wdzz8/ads8688-mos-test-platform/固定栅压输出特性下一步_20261102.md

# 固定栅压输出特性：下一步操作

> 最新状态：DAC2432/2560/2688/2816四条曲线已完成，见[多栅压输出特性实测_20261102.md](output/pcb1/fixed_vgs_20261102/family_20261102_173244/多栅压输出特性实测_20261102.md)。FPGA已恢复DAC256低栅压，ADC复核通过，DPS输出关闭。下文保留第一条曲线的操作过程；当前下一步见[标定与动态下一步_20261102.md](标定与动态下一步_20261102.md)。

当前自动栅压扫描已经完成。要测标准的 MOS 输出特性，需要固定 VGS，只改变 VDS。已有程序继续扫描栅压，不能直接把那组数据当成输出特性。

## 已准备好的镜像

先用这个镜像做第一条固定栅压曲线：

```text
output/mos_fixed_vgs/code_2560/mos_fixed_vgs.bit
output/mos_fixed_vgs/code_2560/mos_fixed_vgs.ltx
```

DAC 码 2560 在前一轮实测对应 VG 约 2.04 V，位于已观察到的导通过渡区。

## 你需要做的唯一硬件动作

1. DPS 输出保持关闭；OPA 正、负电源和 GND 都保持稳定。
2. 当前自动扫描接线保持不变，DG4102 保持断开。
3. 在 Vivado Hardware Manager 手动 Program 上述 `.bit`，同时加载同目录 `.ltx`。
4. 看到 LED3 正常亮、JTAG 仍可识别后，回复“固定2560已下载”。

下载期间不要给 DPS 开输出。这个镜像只把栅压固定在约 2.04 V，ADC 会连续输出稳定快照；随后运行自动 VDS 阶梯采集，每一级结束都关闭 DPS。

## 零点和自动采集

先在 DPS 输出关闭状态下，用同一 `code_2560` 镜像执行一次固定栅压采集，保存为零电流基线。当前已保存的验证基线为：

```text
output/pcb1/fixed_vgs_20261102/zero_code2560.csv
```

该文件包含 256 行有效数据，实测 VG 均值约 2.04446 V，行内范围约 1.25 mV；DPS 回读为输出关闭。

可用自动采集器逐点完成 DPS 阶梯和 ILA 导出：

```powershell
python scripts/capture_fixed_vgs_output.py --port COM3 --dac-code 2560 `
  --zero-csv output/pcb1/fixed_vgs_20261102/zero_code2560.csv
```

每个点默认保存 128 行；任何 DPS 状态异常、ILA 超时、固定 DAC 码不符或采集行数不足都会停止后续点，并尝试验证关闭输出。采集报告保存于 `output/pcb1/fixed_vgs_20261102/run_<timestamp>/`。

## 之后的测量顺序

保持同一接线，DPS 依次设定 0.2、0.5、1.0、1.5、2.0、2.5、3.0 V，限流保持 20 mA；每个点采集 VD、VS、INA OUT，并用 DPS OFF 零点扣除 INA。采集结束后运行：

```powershell
python scripts/analyze_fixed_vgs.py `
  output/pcb1/fixed_vgs_20261102/run_<timestamp>/fixed_vgs_output_report.json
```

本轮 DAC 码2560的实测结果已保存为[固定栅压输出特性实测结果_20261102.md](output/pcb1/fixed_vgs_20261102/固定栅压输出特性实测结果_20261102.md)。随后再构建 2304、2816、3072 等 DAC 码，重复同一组 VDS，得到多条固定 VGS 输出曲线。

## 验收标准

- 每个固定栅压镜像的实测 VG 在全部采样行内变化小于约 20 mV。
- row_valid、ADC 初始化和 DAC 状态正常，不能出现全 FFFF。
- 每个 VDS 点结束后 DPS 回读 `output_enabled=false`、实际输出 0 V。
- 输出数据保留原始 VD/VS/INA；电流标定仍需使用已测 R1 或外部标准电流，暂不宣称数据手册参数已精密测出。
