wdzz8/ads8688-mos-test-platform/初赛创新点与视频策略_20261103.md

# FPGA 创新设计赛道初赛创新点与视频策略

## 1. 通知中真正影响初审的指标

2026 年竞赛通知（第一轮）明确提到，资格审核和作品评审会关注：

- 材料完整度；
- 项目创新性和科学性；
- 工程可行性；
- 设计难度；
- FPGA 平台适用度。

初赛采用作品报告、视频等材料的线上评审。决赛包含作品介绍与演示、专家提问，以及 FPGA 基础编程设计能力考核。因此，初赛材料需要让评委在几分钟内看清楚“为什么必须用 FPGA、系统是否真的运行过、遇到异常是否能处理、结果是否可复现”。

## 2. 建议采用的项目定位

建议项目名称统一为：

> **面向功率 MOS 的 FPGA 闭环参数测试与边缘诊断平台**

建议摘要中的主线是：

> 平台由 AX7020 FPGA 协调 DAC 栅压、可控漏极电源和 ADS8688 八通道采集链路，在 FPGA 端保留时间戳、序号、通道切换标记和坏行标志，在上位机端完成恒 VDS 闭环、质量门控和可解释参数提取，实现从激励、采样、异常恢复到曲线分析的完整证据链。

这比“自动画 MOS 曲线”更能对应竞赛所要求的 FPGA 应用创新、工程实践和复杂问题解决能力。

## 3. 最值得突出且可以真实支撑的三项创新

### 创新一：面向目标 VDS 的闭环测试编排

测试流程不是固定延时后画图，而是：

1. FPGA 输出可编程栅压并连续采集多通道数据；
2. 上位机根据源压扣零后的 VDS 回读误差调整 DPS；
3. 只有在 VDS 落入目标窗口后才接受该点；
4. 每个点保存设定值、回读值、迭代次数和最终接受依据。

当前真实证据是 9 个恒 VDS 转移点，VDS 保持在约 0.500 V ± 15 mV，并且报告保留了每点迭代和电源关闭回读。视频中应把“目标值—第一次误差—调整—接受”做成 10 秒的局部放大镜头。

后续可扩展为“粗扫—发现拐点—局部加密”的自适应采样。初赛可以把它作为已有闭环流程的增强设计，明确标注实机已验证的部分和后续计划，避免把未跑过的策略说成实测结果。

### 创新二：FPGA 端数据质量门控与异常自诊断

ADS8688 的偶发 FFFF 不能被隐藏，反而可以成为工程能力证据。当前链路已经保留：

- 采样序号和时间戳；
- 通道切换标记；
- FFFF/坏行计数；
- 配置变化检测；
- ILA 原始证据；
- 独立 ADC 复位和重新初始化路径。

建议把它命名为“采样质量门控”：坏行直接拒收，触发重初始化，恢复后再继续采集；报告同时保存有效行数、拒收行数、恢复动作和最终 DPS OFF 回读。这样评委看到的是一个能处理现场异常的 FPGA 工程系统，而不是只在正常情况下出一张漂亮曲线。

视频应展示一张真实诊断日志：异常帧被标红、状态机进入恢复态、重新初始化后有效行恢复。不要宣称已经隔离 FFFF 的唯一硬件根因，只说“系统能检测并恢复，根因仍在定位”。

### 创新三：重复性、置信区间和留一验证

每个静态点保留 128 行原始采样，不只输出一条连线。分析层可以同时给出：

- 重复采样标准差或标准误；
- 有效行比例；
- VDS 是否落在接受窗口；
- 经验模型的留一点评估误差；
- 转移曲线的有限差分 gm；
- 动态频率、周期离散度和占空比。

这使“科学性”有可见证据，也能在答辩时回答“曲线是否只是偶然噪声”。当前真实数据已经支持 3,584 个固定栅压输出行、24,576 组动态数据和 9 个恒 VDS 转移点，演示页面也已经展示模型和动态指标。

## 4. 可以作为加分项的扩展

### 4.1 可解释轻量模型和残差地图

当前每条输出曲线使用紧凑经验模型，并保存留一预测。建议在报告中增加“残差随 VDS/VGS 的热力图”，让系统自动指出模型失配最大的区域，并建议下一轮在该区域加密采样。这比直接套用黑盒神经网络更容易解释，也更适合 FPGA 竞赛答辩。

当前已经补充一个独立的研究性智能层：使用真实 28 个静态采样点训练固定种子的 2-8-1 TinyMLP，并进行留一验证；同时根据留一残差和局部斜率变化给出每条曲线的两个候选 VDS 加密点。该模型只用于探索性回归和测试规划，硬件验收仍由 FPGA 标志、DPS 回读和规则窗口完成。演示入口为“智能规划”页，数据文件为 `demo/data/intelligent_analysis.json`，可复现命令为 `python scripts/intelligent_analysis.py`。

### 4.2 器件画像和自动分档

把一次测试的结果保存为器件画像：VGS@1 mA、最大 gm、低压导通电流、饱和区拟合参数、重复性和异常率。将来插入两只 2N7000 或不同型号 MOS 时，可以自动输出“参数相近/异常/需复测”标签。初赛可先展示单器件画像，决赛再扩展多器件对比。

### 4.3 面向安全工作区的测试约束

把 VDS、限流、栅压变化率、单点超时和 DPS OFF 回读写成统一的测试约束，并在界面显示“允许/拒绝原因”。当前软件已经限制 0–5 V、0–50 mA 的控制范围，实验数据使用不超过 3 V、20 mA 的包络；独立硬件关断尚未完成验证，因此材料中应称为“软件测试约束和关断回读”，不要称为独立硬件保护。

### 4.4 可插拔器件配置

将通道映射、分流电阻、放大倍数、DAC 范围和安全上限放入器件配置文件，使平台从“2N7000 专用”变为“可换器件测试框架”。这是工程化加分项，适合写进设计难度和后续展望，当前不需要为了它重构全部 RTL。

### 4.5 FPGA 实现证据页

竞赛明确考察 FPGA 平台适用度。当前已从交付 bit/LTX、综合日志和 timing report 生成工程指标页，展示 50 MHz 目标时钟、8 通道 416 µs 行周期、ILA 证据、Setup WNS、Hold WHS、失败端点数以及综合 LUT/寄存器/CARRY4 数量。它能把“用了 FPGA”具体化为可审查的确定性数据路径和实现结果。

## 5. 截止提交前的优先级

### 必做

1. 报告和视频统一使用“闭环测试 + 质量门控 + 可解释分析”三条主线；
2. 展示真实 PCB、AX7020 下载、DPS 回读和原始采样证据；
3. 在画面上明确区分实测值、名义换算值和趋势代理；
4. 附上源代码、bit/LTX、复现命令和离线演示入口；
5. 准备一个异常恢复镜头和一个恒 VDS 收敛镜头。

### 有时间再做

1. 在离线演示增加“质量门控/异常恢复”标签页；
2. 在分析 JSON 增加每个点的有效率、标准差和残差；
3. 增加“下一采样点建议”的自适应规划器，并标记为规划器演示或离线回放；
4. 添加器件画像导出 JSON/CSV。

### 不建议在提交前临时加入

- 没有实机证据的神经网络或“AI 自动识别”宣传；
- 未验证的精密绝对电流精度、MOS 本征开关速度和独立硬件保护；
- 只增加按钮、动画或 3D 外观而不增加 FPGA 数据路径和可复现实验；
- 伪造数据、伪造实物效果或把离线回放说成现场实测。

## 6. 三分钟视频建议结构

1. **0:00–0:20 问题**：人工示波器/万用表无法同时完成可编程激励、八通道同步证据和异常筛选。
2. **0:20–0:50 架构**：AX7020、MCP4725、ADS8688、DPS、INA240、MOS 测试板的信号流。
3. **0:50–1:25 实物运行**：下载 FPGA、设置栅压、DPS 输出、实际 MOS 和界面同步变化。
4. **1:25–1:55 闭环证据**：恒 VDS 目标、调整过程、9 点结果和 0.500 V ± 15 mV。
5. **1:55–2:20 异常恢复**：FFFF/坏行标记、拒收、重新初始化、恢复后的有效数据。
6. **2:20–2:45 算法结果**：输出特性、转移曲线、gm、频率/占空比、重复性和留一误差。
7. **2:45–3:00 竞赛价值**：FPGA 数据路径、工程约束、开放源代码、后续可插拔器件和自适应采样。

## 7. 边界表述

当前项目可以有竞争力，但材料应把“实测已完成”和“规划增强”分开写。精密电压/电流标定、FFFF 的唯一根因、独立硬件关断目前仍是限制项；它们不妨碍展示系统的闭环流程和工程化能力，却不能被写成已经完成的验收结论。
