wdzz8/ads8688-mos-test-platform/交付状态_20261102.md

# 交付状态（2026-11-02）

## 已完成

- 统一实验固件 `output/mos_experiment/mos_experiment.bit/.ltx` 已构建并在 AX7020 上实测。
- 固定 VGS 输出特性：4 个栅压、7 个漏极点、每点 128 行，共 3,584 个有效行。
- 动态方波：1、5、10 Hz 各 8,192 组，共 24,576 组；实测频率约 0.99994、5.00020、10.00088 Hz，占空比约 0.5；每轮 DPS 输出均 OFF 回读。
- 恒 VDS 转移特性：9 个栅压点，VDS 均在 0.5 V ± 15 mV；已提取有限差分 gm 和阈值趋势代理。
- 分析脚本会重新读取原始 CSV，拒绝 FFFF、坏行、错误 DAC 码和未经验证的电源状态。
- 离线交互演示 `demo/index.html`、紧凑数据 `demo/demo_data.js`、数据回放 `demo/mos_data_replay.mp4` 已生成。

## 关键复现命令

```powershell
python scripts/analyze_experiments.py
python scripts/build_demo_bundle.py
python scripts/render_demo_video.py
python -m unittest discover -s tests -p "test_*.py" -v
```

双击 `demo/index.html` 可以离线查看页面。实物拍摄请按 `视频拍摄分镜_20261102.md` 执行。

## 结论边界

当前 ID 使用 INA240 20 V/V、0.1 Ω 分流器的名义系数，并用匹配 DPS OFF 基线扣除零点；精密绝对电压/电流标定仍未完成。经验模型用于比较和留一验证，不等同于 MOS 本征模型。动态频率指标是整机采样系统响应，不代表 MOS 本征开关速度。此前 ADC FFFF 可通过重新初始化恢复，但根因仍保留在历史诊断文档中。

## GitHub

公开仓库：[wdzz8/ads8688-mos-test-platform](https://github.com/wdzz8/ads8688-mos-test-platform)。本地交付基线 `485d741` 已推送，当前 README 链接更新正在同步。
