wdzz8/ads8688-mos-test-platform/完整硬件接线与测试说明_20261101.md

# AX7020 + ADS8688 + MCP4725 + OPA192 + INA240 + 2N7000

当前接线已切换为 2026-11-02 新 Q1 的截止复测，以 [当前PCB完整接线_截止复测_20261102.md](当前PCB完整接线_截止复测_20261102.md) 为准。本文件保留历史完整/导通接法；当前 J9 接地、OPA 输出断开、J16-5 漏极采样线暂时断开，不能混用两种状态。

## 1. 项目目标

系统用于测量 2N7000 的静态特性。AX7020 负责数字控制和数据采集，MCP4725/OPA192 产生栅极电压，DPS 产生漏极电压，INA240 把源极电流变成可采集的电压，ADS8688 采集栅极、漏极、源极和电流信号。

当前阶段先做低压、短时、可人工确认的测试；DPS 输出暂时由面板/电脑手动控制，不能把 DPS 误认为已经由 FPGA 自动控制。

## 2. 已确认的硬件

- AX7020：FPGA 为 XC7Z020，AX7020 实物上的扩展接口是 **J11**。
- PCB 上对应的扩展接口是 **J21**；如果使用排线连接，按相同针号把 AX7020 J11 接到 PCB J21。后文凡写 J11 都指 AX7020，凡写 J21 都指 PCB。
- Q1：工程中为 onsemi 2N7000，TO-92-3L。
- 对本次实物“2N7000 JCAZW”，平面朝向自己、引脚向下时，已由体二极管测试确认：1=S，2=G，3=D。
- PCB 已焊好 Q1、R1、R2、R3 等元件；外部模块和旧台架线尚未迁移。
- DPS 电脑通信已经恢复，COM3 可识别；最新已确认的测试状态是输入约 11.97 V、设定 1.00 V/20 mA、输出关闭。

## 3. 整个功率和测量回路

```text
DPS OUT+ ──> J10-1 (VD_SUPPLY) ── PCB R1=1 kΩ ──> Q1-3 D
DPS OUT- ──> J10-2 (GND)

Q1-1 S ──> VS ──> INA240 IN+
                  INA240 模块内部分流电阻
              INA240 IN− ──> 公共 GND ──> J10-2/DPS OUT−

栅极源 ──> J9 中心 ── SW1(AUTO) ── PCB R2=1 kΩ ──> Q1-2 G
Q1-2 G ── PCB R3=100 kΩ ──> GND
```

因此，PCB 上已经有：

- R1=1 kΩ：`VD_SUPPLY` 到 Q1 漏极 `VD`；
- R2=1 kΩ：`VCTRL` 到 Q1 栅极 `VG`；
- R3=100 kΩ：`VG` 下拉到 GND。

迁移到 PCB 后，旧台架的 100.50 Ω 漏极电阻、910 Ω 栅极电阻、外部 100 kΩ 下拉都应拆掉，不要与板上 R1/R2/R3 叠加。DPS 正端接 J10-1，不能直接接 Q1-3。

## 4. INA240 只有一个

整套系统只使用一个外置 INA240 模块。J2 和 J14 是同一组 VS/GND 网络的两种引出方式，J14 不是第二个 INA240。

推荐使用 J2 的完整六针接口：

| PCB | INA240 模块 |
|---|---|
| J2-1 | VCC，接 +5V_ANA |
| J2-2 或 J2-3 | GND |
| J2-4 | OUT，送 ADS8688 模拟输入 |
| J2-5 | IN− |
| J2-6 | IN+ |

使用这个方案时 J14 完全不接线。

如果线束必须分开，也可使用方案 B：J2-1 接 VCC，J2-2/3 接 GND，J2-4 接 OUT，J14-1 接 IN+，J14-2 接 IN−；此时 J2-5、J2-6 不接。方案 A 和方案 B 只能选一个，不能接两个 INA240，也不能用导线把 VS 直接短到 GND，否则会旁路 INA240 的分流电阻，电流读数会失效。

## 5. 栅极部分

### 自动栅压链路

```text
MCP4725 VOUT ──> J8 中心 ──> OPA192 输入
OPA192 输出 ──> J9 中心 ──> SW1 的 AUTO 端
SW1 AUTO ──> VCTRL ── PCB R2=1 kΩ ──> Q1 G
```

OPA192 使用 +5 V、GND、−5 V 三电源，电源接 J7/J13 对应端子。J8/J9 的外壳均为 GND。

### 第一次固定电压检查

先不要让 OPA 输出和 MCP4725 输出同时接到栅极。DPS 关闭时，可以把已确认的 3.3 V 安全地送到 J9 中心，SW1 拨到 AUTO，使用板上 R2/R3。由于 R3=100 kΩ 下拉，理论栅压约为 `3.3×100k/(100k+1k)=3.27 V`，应使用万用表测 Q1-2 对 Q1-1 的 VGS。

如果万用表读到约 0.005 mV，说明栅极没有得到 3.3 V，通常是供电点、SW1 位置或 J9 中心接线错误；这不表示 MOS 已损坏。

## 6. AX7020、ADS8688、MCP4725 的线

### AX7020 J11 到 PCB J21

| AX7020 | PCB | 信号 |
|---|---|---|
| J11-1 | J21-1 | GND |
| J11-2 | J21-2 | +5V_FPGA |
| J11-3 | J21-3 | ADC_CS_N |
| J11-4 | J21-4 | ADC_SCLK |
| J11-5 | J21-5 | ADC_SDI |
| J11-6 | J21-6 | ADC_SDO |
| J11-7 | J21-7 | ADC_RST_N |
| J11-9 | J21-9 | MCP_SCL |
| J11-10 | J21-10 | MCP_SDA |
| J11-37/38 | J21-37/38 | GND |
| J11-39/40 | J21-39/40 | +3.3V |

J11-2/J21-2 是 FPGA 侧 5 V 电源标识，不要把它误认为 ADS8688 的模拟 5 V。ADS8688 和 INA240 的模拟 5 V 仍按下面的 J15/J2 供电；J11-9/J11-10 也不是电源，而是 I2C。

如果使用杜邦线而不是 40 针排线，至少接以下信号：

| AX7020 J11 | PCB J21 | 信号 |
|---|---|---|
| J11-3 | J21-3 | ADC_CS_N |
| J11-4 | J21-4 | ADC_SCLK |
| J11-5 | J21-5 | ADC_SDI |
| J11-6 | J21-6 | ADC_SDO |
| J11-7 | J21-7 | ADC_RST_N |
| J11-9 | J21-9 | MCP_SCL |
| J11-10 | J21-10 | MCP_SDA |
| J11-37/38 | J21-37/38 | GND |
| J11-39/40 | J21-39/40 | +3.3V |

### ADS8688 模块

- ADS8688 模拟电源接 +5 V，GND 接公共地，DAISY 接 GND。
- ADS 模块数字线接 PCB J15：J15-1/2/3/4/5 分别为 SDI/RST/SCLK/CS/SDO；J15-6～9 接 GND；J15-10 接 +5V_ANA。
- PCB J16 是模拟采样口：J16-3=ADC_ID，J16-4=ADC_VG，J16-5=ADC_VD，J16-6=ADC_VS；J16-1 和 J16-10 接 GND。

模块丝印从 AIN1 开始，而芯片通道从 CH0 开始，所以物理对应是：

- J16-3 → 模块 AIN8 → 芯片 CH7：INA240 OUT；
- J16-4 → 模块 AIN1 → 芯片 CH0：VG；
- J16-5 → 模块 AIN2 → 芯片 CH1：VD；
- J16-6 → 模块 AIN3 → 芯片 CH2：VS。

### MCP4725 模块

- J6-1/J6-5：GND；
- J6-2：+3.3 V；
- J6-3：SDA；
- J6-4：SCL；
- J6-6：MCP4725 VOUT/DAC_GATE_RAW。

SDA、SCL 各保留一个约 2.2 kΩ～4.7 kΩ 的上拉到 3.3 V；模块 A0 按当前工程使用 0x60 地址的接法保持不变。

## 7. 断电检查顺序

所有电源关闭、DPS OUT 关闭、万用表电阻档：

1. J10-1 到 Q1-3 应约为 1 kΩ；J10-1 到 GND 不应短路。
2. Q1-2 到 GND 应约为 100 kΩ。
3. SW1 拨 AUTO 时，J9 中心到 Q1-2 应约为 1 kΩ；拨 MANUAL 时，检查 RV1 到 VG_MANUAL 的变化。
4. Q1-1、J14-1、J2-6 应为同一网络；J14-2、J2-5、GND 应为同一网络。
5. J10-2、J14-2、INA240 GND、ADS GND、MCP GND、AX7020 GND 必须互通。
6. 不应存在 J10-1 到 GND、J9 中心到 GND 的异常低阻短路。

## 8. 上电和测量顺序

1. 断开 DPS 输出，只上 AX7020、ADS8688、MCP4725、INA240 和 OPA192 的低压电源；先量 +3.3 V、+5 V、−5 V。
2. 下载同一次生成的 `mos_scan.bit` 和 `mos_scan.ltx`，检查 ADS8688 初始化、MCP4725 ACK、ILA 数据是否正常。
3. 栅极先保持 SW1=MANUAL、RV1 最低，或让 J9 输入一个已知的 0 V；确认 VGS≈0 V。
4. 送 3.3 V 到 J9 中心、SW1=.AUTO，在 DPS 仍关闭时测 VGS；预期约 3.27 V。
5. DPS 设 1.00 V、限流 20 mA，正端接 J10-1、负端接 J10-2，先测 VDS（红笔 Q1-3，黑笔 Q1-1）。
6. VGS≈0 V 时，VDS 应接近 1 V；VGS≈3.27 V 时，VDS 应明显下降并出现源极电流。每次只开启很短时间，观察 DPS 是否进入 CC。
7. 同时记录：DPS 输出电压、Q1 VDS、Q1 VGS、VS 对 GND、INA OUT 对 GND 和 ADS8688 对应通道。
8. 通过 1 V 低压确认后，再逐步提高漏极电压或扫描栅压；不要直接跳到高电压。

## 9. 已完成的实验说明

- 体二极管方向一次约 0.5896 V、反向 OL，支持 1=S、2=G、3=D 的判断。
- G/S 短接、DPS 1.00 V/20 mA 时测到 VDS=1.003 V，DPS 回报 0.000 A。这是截止检查，不是完整漏电流精度证明。
- 100.50 Ω 旧台架负载下，1 V 测得 0.9790 V；3 V/20 mA 条件下测得约 2.23 V，说明曾经接近限流边界。
- 之前固定栅压测试的 VGS=0.005 mV，是 3.3 V 取电链路没有建立的结果，不能作为 MOS 导通能力结论。

## 10. 精度边界

真正的低电流精度主要受 INA240 模块零点、内部分流电阻阻值、INA 增益误差、ADS8688 量程/基准、DPS 显示分辨率以及 MOS 温度影响。不能只看 FPGA 的 ADC 码值就宣称精度。

正式扫描前应先记录：DPS 关闭、VGS=0 时的 INA OUT 零点；再用已知电流点做增益校准。若模块是常见增益 20、分流电阻 0.1 Ω 版本，电流换算近似为：

```text
I = (INA_OUT - INA_ZERO) / (20 × 0.1 Ω)
```

实际使用时还要用实测增益和实测分流电阻替换名义值。低于几毫安的点先标为“待校准”，不要把它们当成高精度数据。

## 11. 当前没有完成的部分

- PCB 迁移后的断电通断检查尚未实测记录。
- 外部模块到 J2/J6/J15/J16/J21/J10 的线尚未全部接好。
- DPS 的 FPGA 自动控制接口仍是预留项；目前 DPS 由 COM3/面板控制。
- `mos_scan` 的自动曲线只有在栅极、漏极和 INA/ADC 通道实测确认后，才可以作为有效 MOS 曲线。
