wdzz8/ads8688-mos-test-platform/当前PCB完整接线_截止复测_20261102.md

# 当前 PCB 完整接线：新 Q1 截止复测（2026-11-02）

> 此文件是历史截止复测状态，OPA 断开/J9 接地的要求不适用于当前自动扫描。当前接线见 [当前PCB自动扫描接线_20261102.md](当前PCB自动扫描接线_20261102.md)。

本文件给出本轮目标接线，不表示所有接线已由仪器确认。AX7020 上用 J11，PCB 上用 J21。当前任务是复测新焊接 Q1 在 VGS≈0 V、DPS 输出 1.00 V 时的截止行为。全部改线必须断电，DPS OUT 关闭。

## 本轮三个关键状态

- PCB J9 中心接 PCB GND，SW1 选择 AUTO；原 3.3 V 栅压测试线拆掉。
- OPA192 输出与 PCB J9 断开，DG4102 输出线断开；OPA 输入和供电可保留。
- PCB J16-5 到 ADS8688 模块 AIN2 的漏极采样线暂时断开；PCB J4 不接仪器。

## 1. AX7020 与 PCB

若已使用 40 芯排线，保持 AX7020 J11 与 PCB J21 同针号连接，按连接器 Pin 1 标识核对方向；不要按照片左右方向猜针号。若用杜邦线，本轮使用的连接如下：

```text
AX7020 J11-3  -> PCB J21-3   ADC CS
AX7020 J11-4  -> PCB J21-4   ADC SCLK
AX7020 J11-5  -> PCB J21-5   ADC SDI
AX7020 J11-6  -> PCB J21-6   ADC SDO
AX7020 J11-7  -> PCB J21-7   ADC RST
AX7020 J11-9  -> PCB J21-9   MCP SCL
AX7020 J11-10 -> PCB J21-10  MCP SDA
AX7020 J11-37 -> PCB J21-37  GND
AX7020 J11-38 -> PCB J21-38  GND
AX7020 J11-39 -> PCB J21-39  +3.3 V
AX7020 J11-40 -> PCB J21-40  +3.3 V
```

J11-1/J21-1 也为 GND。J11-2/J21-2 为 +5V_FPGA，和 +5V_ANA 是不同网络；本轮不用另外从这一脚给模拟模块供电。PCB J20 不用。AX7020 沿用自身已验证的电源与 USB JTAG。

J21 到 J15/J6 的连接已在 PCB 内，不再另加跨接线。SPI/I2C 原来直接连接 AX7020 和模块的重复线束应移除，统一经过 PCB。

## 2. IT 模拟电源与 PCB

第一台 IT6302 沿用已经验证的 +5 V、0 V、−5 V 三个节点，不重新猜测通道端子极性：

```text
已验证的 +5 V -> PCB J13-1 (+5V_ANA)
系统 0 V     -> PCB J13-2 (GND)
已验证的 -5 V -> PCB J13-3 (-5V_OPA)
```

本轮只从 J13 输入模拟电源。PCB P1 留空，因为 P1-1 与 J13-1 同网、P1-2 与 J13-2 同网。原来 CH3 独立 +5 V 到 ADS/INA 的供电线应断电移除，避免把独立电源输出直接并接到 +5V_ANA。ADS/INA 改由 PCB J15/J2 取电。

AX7020 的 3.3 V 给 MCP4725；不要新增另一台 3.3 V 电源并联到这条电源轨。

## 3. INA240：只使用一个模块

统一使用 J2 完整接口，J14 留空：

```text
PCB J2-1 -> INA240 VCC (+5 V)
PCB J2-2 -> INA240 GND（J2-3 是相同 GND，可代替 J2-2）
PCB J2-4 -> INA240 OUT
PCB J2-5 -> INA240 IN-
PCB J2-6 -> INA240 IN+
```

Q1 源极 VS 经模块已有 R100 分流电阻回地。不要额外把 Q1 源极直接短到 GND，也不要新增分流电阻。INA OUT 已通过板上采样网络送 J16-3，不再额外直连 ADC。

## 4. ADS8688

数字及供电：

```text
PCB J15-1  -> ADS SDI
PCB J15-2  -> ADS RST
PCB J15-3  -> ADS SCLK/CLK
PCB J15-4  -> ADS CS
PCB J15-5  -> ADS SDO
PCB J15-6  -> ADS GND（J15-7/8/9 也为 GND，不要求四脚全部各拉一根）
PCB J15-10 -> ADS VCC/AVDD (+5 V)
ADS DAISY  -> ADS 模块 GND
```

本轮模拟输入：

```text
PCB J16-3  -> 模块 AIN8 / P2-3（芯片 CH7），电流采样
PCB J16-4  -> 模块 AIN1 / P2-4（芯片 CH0），栅压 VG
PCB J16-5  -> 暂不接，ADS 模块 AIN2 / P2-5 的这根线拔掉
PCB J16-6  -> 模块 AIN3 / P2-6（芯片 CH2），源压 VS
PCB J16-1  -> ADS 模块模拟 GND（J16-10 也是 GND）
```

J16-2/7/8/9 本轮不接；PCB J4 和其余模拟测试端子不接示波器/其他外部负载。模块 AIN1～AIN8 与芯片 CH0～CH7 的编号有一位差异。漏极采样线恢复前，ADC CH1 的数据不能用作有效 VDS。

## 5. MCP4725

```text
PCB J6-1 -> MCP GND（J6-5 同为 GND）
PCB J6-2 -> MCP VCC/VDD (+3.3 V)
PCB J6-3 -> MCP SDA
PCB J6-4 -> MCP SCL
PCB J6-6 -> MCP VOUT/OUT
```

SDA/SCL 保留已验证的 3.3 V 上拉和 A0 地址 0x60 接法，不重复增加上拉。J6-6 与 J8 中心同网。MCP 输出可保留接 OPA 输入，但本轮 OPA 输出必须与 J9 断开，所以 FPGA 即使输出扫描波形也不应驱动栅极。

## 6. OPA192、DG4102 和 J9

PCB J7 针序已从最终工程确认：

```text
PCB J7-1 -> OPA192 VDD / +VS / 正电源 (+5 V)
PCB J7-2 -> OPA192 GND
PCB J7-3 -> OPA192 VEE / -VS / 负电源 (-5 V)
PCB J8 中心/外壳 -> OPA192 SMA-IN 中心/外壳
```

OPA192 模块电源端仍按其实际丝印匹配信号，不能假定模块插座左右方向与 PCB 相同。模块原有直供电线不要与 J7 重复接入另一台电源。

**本轮 OPA192 SMA-OUT 到 J9 的线拔掉。DG4102 输出线与 PCB/OPA 输入断开。**

```text
PCB J9 中心 -> PCB J9 外壳 / 公共 GND
SW1         -> AUTO（工程网络为 SW1-1 VG_AUTO，SW1-2 VCTRL）
```

因此，Q1 栅极经板载 R2 接地，R3 也保留在板上，不需要直接短接 Q1 引脚。

## 7. Q1 和板载电阻

```text
Q1 焊盘 1 = VS = 源极 S
Q1 焊盘 2 = VG = 栅极 G
Q1 焊盘 3 = VD = 漏极 D
```

对本次同批裸管，平面朝用户、引脚向下时，左/中/右已由体二极管测试支持 S/G/D；安装时须与 PCB 焊盘编号匹配，不凭器件旋转后的“左脚”猜网络。

- R1 设计 1 kΩ，用户实测约 0.99 kΩ：VD_SUPPLY 到 VD。
- R2 设计 1 kΩ：VCTRL 到 VG。
- R3 设计 100 kΩ：VG 到 GND。
- 不再接旧台架的 100.50 Ω、910 Ω或外部 100 kΩ；裸管测试用 100 kΩ不移到 PCB。

## 8. DPS3005 和第二台 IT6302

第二台 IT6302 的原独立 12 V 通道：

```text
同一通道 +12 V 正端 -> DPS IN+
同一通道负端       -> DPS IN-
DPS OUT+           -> PCB J10-1 (VD_SUPPLY)
DPS OUT-           -> PCB J10-2 (GND)
```

输入侧保持原已验证接法，不新增到系统地的跨接；不假定 DPS 输入/输出隔离。DPS 使用配套 USB 通信板接电脑：COM3、9600、8N1、地址 1；不接 AX7020 UART。

设定 1.00 V、0.020 A，输出先关闭。软件“打开/关闭”是输出开关，“断开”是通信开关。DPS 正端不能直接接 Q1 漏极绕过 R1。

功率回路为：DPS OUT+ → J10-1 → R1 → Q1 D → Q1 S → INA 模块分流电阻 → GND → J10-2 → DPS OUT−。

## 9. 公共地和本轮上电

公共地是 PCB GND、AX7020 J11 GND、ADS GND、MCP GND、INA GND/IN−、OPA GND、DPS OUT−、第一台 IT 的系统 0 V。−5 V 电源轨不等于 GND。

1. 全部断电完成上面的线束和新 Q1 焊点检查。
2. 开启 AX7020 与第一台 IT 的模拟电源，确认 +3.3 V、+5 V、−5 V 对系统 GND 的极性。
3. 开启给 DPS 输入供电的约 12 V 通道，确认 DPS OUT 关闭，设定 1.00 V/0.020 A。
4. 万用表直流电压档，红 Q1-2、黑 Q1-1，确认 VGS 接近 0 V。
5. 红 Q1-3、黑 Q1-1，开启 DPS 数秒，记录 VDS 和实际输出电压，随后关闭输出。此次截止 VDS 预期接近 1 V，异常时不升压。
6. 本轮不要求重新下载波形固件，不需要 DG4102 或示波器。只有确认截止恢复后，才恢复 J16-5 采样线做对照；OPA 输出恢复前要先解除 J9 对地连接。

## 10. 状态记录

用户报告 Q1 已更换重焊；新 Q1 在漏极采样断开时测得截止 VDS=1.003 V，接回 J16-5 后用户确认仍正常。固定栅压复测 VGS=3.248 V、VDS=3.25 mV、DPS 电流显示 0.001 A，基本导通检查通过；这不代表电流精度校准完成。备用裸管在 1、2 脚间跨接 100 kΩ时，红 1 黑 3 为 0.586 V，反向 OL，体二极管检查通过。旧 Q1 在板上测到 0.3149 V/缓慢升到 2.17 V，尚不能判定为连锡、损坏或焊反。旧截止状态 J10≈1 V、VD≈0.8712 V 的根因未单独确认。

下一步准备自动栅压扫描：DPS 输出关闭；断电拆掉固定 3.3 V 栅压线、解除 J9 对地连接，恢复 OPA192 OUT 到 J9；J16-5 保持接回。新状态须由用户确认后才下载和采集；本文件上半部仍描述截止复测接法，不能混用两个栅极状态。
