wdzz8/ads8688-mos-test-platform/当前PCB自动扫描接线_20261102.md

# 当前 PCB 自动扫描接线（2026-11-02）

这是恢复 OPA 输出后的自动扫描状态，取代旧的截止复测接法。用户已下载 mos_scan，并在 OPA 负电源恢复、重新初始化 ADC 后通过 1 V 自动扫描。改线时关闭全部电源；测试结束时 DPS OUT 应关闭。引脚编号按连接器 Pin 1 标记识别。

## AX7020 与 PCB

AX7020 使用 **J11**，PCB 使用 **J21**。两侧相同针号连接：3=ADC CS、4=SCLK、5=SDI、6=SDO、7=RST、9=MCP SCL、10=MCP SDA、37/38=GND、39/40=3.3 V。使用已核对方向的 40 芯排线时，不重复增加相同信号的杜邦线。J11-2/J21-2 的 +5V_FPGA 本轮不用作模拟电源。

## 模拟电源与 OPA192

第一台 IT 保持已验证的 +5 V、0 V、−5 V 接法：

```text
+5 V → PCB J13-1
GND  → PCB J13-2
−5 V → PCB J13-3

PCB J7-1 → OPA 正电源 +VS / VDD
PCB J7-2 → OPA GND
PCB J7-3 → OPA 负电源 −VS / VEE
```

P1 留空；不要把独立 CH3 的 +5 V 与这条 +5V_ANA 并联。负电源不是 GND。OPA 模块端按实际丝印连接，不按左右方向猜测。

## MCP4725 与栅极驱动

```text
PCB J6-1（或5）→ MCP GND
PCB J6-2       → MCP VCC（3.3 V）
PCB J6-3       → MCP SDA
PCB J6-4       → MCP SCL
PCB J6-6       → MCP VOUT
PCB J8         → OPA SMA-IN（中心信号、外壳地）
OPA SMA-OUT    → PCB J9（中心信号、外壳地）
SW1           → AUTO
```

保留原已验证的 3.3 V I2C 上拉及地址 0x60 接法。固定 3.3 V 到 J9 的测试线、J9 中心到 GND 的短接线均已拆除。DG4102 与电路断开。不要再使用旧截止文件要求的 J9 接地状态。

## INA240：只使用一个模块

```text
PCB J2-1 → INA VCC（+5 V）
PCB J2-2或3 → INA GND
PCB J2-4 → INA OUT
PCB J2-5 → INA IN−
PCB J2-6 → INA IN+
```

J14 留空。源极通过模块已有 R100 分流电阻回地，不额外把源极短接到 GND。当前使用名义增益 20 V/V、名义分流电阻 0.1 Ω，仍需精密标定。

## ADS8688

```text
PCB J15-1  → ADS SDI
PCB J15-2  → ADS RST
PCB J15-3  → ADS SCLK/CLK
PCB J15-4  → ADS CS
PCB J15-5  → ADS SDO
PCB J15-6（或7/8/9）→ ADS GND
PCB J15-10 → ADS VCC/AVDD（+5 V）
ADS DAISY  → ADS GND

PCB J16-3 → 模块 AIN8 / 芯片 CH7（INA OUT）
PCB J16-4 → 模块 AIN1 / 芯片 CH0（VG）
PCB J16-5 → 模块 AIN2 / 芯片 CH1（VD，保持接回）
PCB J16-6 → 模块 AIN3 / 芯片 CH2（VS）
PCB J16-1或10 → ADS GND
```

未使用的 J16-2/7/8/9 不接。当前固件 CH1 漏压量程为 0～5.12 V；自动测试程序仅提供已限定的 1/2/3 V 三档。CH0、CH2 是 ±10.24 V 量程。

## 漏极电源与 Q1

第二台 IT 的原独立 12 V 通道正/负端接 DPS IN+/IN−；保持原输入侧接法，不新增输入输出之间的地线跨接。

```text
DPS OUT+ → PCB J10-1
DPS OUT− → PCB J10-2

Q1-1 = S / VS
Q1-2 = G / VG
Q1-3 = D / VD
```

板上 R1 实测约 990 Ω，串在 J10-1 与漏极之间；R2=1 kΩ、R3=100 kΩ。不增加旧裸管台架的外接电阻，不绕过 R1。电流路径为 DPS OUT+ → R1 → Q1 D/S → INA 模块分流电阻 → GND → DPS OUT−。USB 控制使用 COM3、9600、8N1、地址 1。

## 采集与数据解释

FPGA 使用匹配的 `output/mos_scan/mos_scan.bit` 与 `.ltx`，32 点、DAC 步进 128、每点等待 20 ms、8 次 ADC 整扫平均，自动重复。各轮 ILA 再采每点 8 次。DPS 输出关闭时也会扫描栅压。

测试顺序为 DPS OFF 零点采集 → 检查真实栅压阶梯 → 有限时长带电采集 → 自动关闭并回读。模拟供电变化后须重新检查 ADC；全通道 FFFF 数据无效，不能因 LED 或初始化标志正常而接受。

电流按相同栅压点/DAC 码的零点扣除；电压保留原始 ADC 换算值。VS 通道目前约有 −13 mV 零偏，电流增益也未精密标定。R1 会使 VDS 随栅压变化，因此本轮是带串联负载的栅压扫描，不等同于固定 VDS 的转移特性或固定 VGS 的输出特性。

最新实采记录、故障排除与曲线见 `output/pcb1/live_capture_20261102/` 及 `output/pcb1/bringup_state_20261102.json`。
