wdzz8/ads8688-mos-test-platform/当前台架完整接线_20261101.md

# 当前台架完整接线：2N7000固定栅压基本检查

历史台架记录：当前已使用最终 PCB 并更换 Q1，请按 [当前PCB完整接线_截止复测_20261102.md](当前PCB完整接线_截止复测_20261102.md) 接线。下文的外置 100.50Ω/910Ω/100kΩ 台架支路不是当前 PCB 接法。

2026-11-01更新。本文是当前模块台架的目标接线，供逐线核对；不表示全部接线及电压已重新实测确认。用户报告PCB已到货，最终板图尚未提供。

本轮DPS设定1.00V/0.020A，改线时OUT保持关闭。截止测试已完成：G/S短接时VDS=1.003V，结束后输出关闭；固定栅压导通测试尚未执行。用户报告改线后VGS为0.005mV，3.3V到栅极的供电链仍待检查。

## 1. 2N7000方向与电流回路

针对本次丝印“2N7000 JCAZW”的器件，平面朝自己、引脚向下：左1=S、中2=G、右3=D。该分配由本次体二极管测量支持；不能套用到其他三脚器件。

```text
DPS OUT+ -> 实测100.50Ω串联电阻 -> MOS D(3)
MOS S(1) -> INA240 IN+ -> 模块板载R100(0.1Ω) -> INA240 IN- -> 公共GND
DPS OUT- -------------------------------------------------> 公共GND
```

INA模块IN-、GND均接公共GND。S必须经模块分流电阻回到地；不要另用导线把S直接接地，否则会旁路电流测量。100.50Ω为本轮台架漏极限流电阻，不能与PCB参考图中R1=1kΩ混为一只。

## 2. 本轮固定栅压接线

```text
AX7020的3.3V电源节点 +--> MCP4725 VCC（模块上可能标VDD）
                    |
                    +--> 0.91kΩ(910Ω) --> MOS G(2)
                                           |
                                         100kΩ
                                           |
                                         MOS S(1)
```

原来G(2)与S(1)之间的直接短接线应拆掉，G/S仅由100kΩ电阻相连。是否已经拆掉尚待用户确认。910Ω用于替代此处1kΩ栅极串联电阻。

MCP4725的VCC供电继续保留；从3.3V节点另分支接栅极电阻。当前固定电源驱动G时，OPA192 OUT与MCP4725 OUT均不接G，避免多个输出相连。

已核对AX7020原理图：J11-39/J11-40=VCC3V3；J11-1/J11-37/J11-38=GND；J11-2=5V。按实物连接器1脚标记定位，不能仅按照片左右方向数脚。用户当前VCC线所接的实际针脚尚未核对。

排查测量：黑笔固定MOS S(1)，红笔先接910Ω靠AX7020的一端，确认取电端约3.3V；再接G(2)测VGS，预计约3.27V。万用表读数保留单位。两次测量期间DPS OUT均关闭。

## 3. 供电与公共地

- AX7020沿用板卡原有5V电源正常供电；USB JTAG连接不能代替确认板卡电源已开启。
- 第一台IT6302保持已有配置：CH1/CH2组成OPA192的+5V/GND/-5V；CH3提供原有单路5V/GND。
- OPA192模块VDD接+5V，GND接公共GND，VEE接-5V，沿用已验证的供电端子。
- INA240模块VCC接+5V，GND接公共GND。
- ADS8688模块VCC/AVDD接原有+5V，GND接公共GND，DAISY接GND；模块按已验证的5V方式供电。
- MCP4725模块VCC接AX7020的3.3V，GND接公共GND。
- 公共GND包括AX7020 GND、ADS8688 GND、MCP4725 GND、OPA192 GND、INA240 GND、INA240 IN-、DPS OUT-和第一台IT6302的系统0V参考点。第一台的-5V是电源轨，不是公共GND。
- 第二台IT6302沿用独立12V通道：同一通道正端接DPS IN+，负端接DPS IN-。输入侧不新增到系统GND的跨接线，保持已经验证的供电方式；不作输入/输出隔离假设。
- DPS通过配套USB通信板接电脑，当前COM3，9600波特、8N1、地址1。

## 4. 数字信号

ADS8688模块到AX7020：

- CS -> J11-3。
- SCLK -> J11-4。
- SDI -> J11-5（FPGA输出至ADC）。
- SDO -> J11-6（ADC输出至FPGA）。
- RST -> J11-7。

MCP4725模块到AX7020：

- SCL -> J11-9。
- SDA -> J11-10。
- SDA/SCL分别有2.2kΩ至4.7kΩ上拉到3.3V；保留已验证接法。
- 当前固件使用I2C地址0x60，沿用原A0设置。

## 5. 当前模拟测量与OPA状态

- INA240 OUT -> ADS8688模块AIN8，即芯片CH7、模拟接口P2-3。
- PCB版本只使用一个INA240模块：推荐用J2六针完整接口（J2-1 VCC、J2-2/3 GND、J2-4 OUT、J2-5 IN−、J2-6 IN+），J14留空；若采用分开接线，则用J2-1/2/3/4接供电和输出，J14-1/2接IN+/IN−，J2-5/6留空。J14与J2-5/6是同一组VS/GND网络，不是第二个INA240。
- 本轮先用万用表测VGS/VDS；其余ADC模拟线不作为已经确认的连接。
- 测VGS：红G(2)，黑S(1)。测VDS：红D(3)，黑S(1)。
- MCP4725 OUT -> OPA192 SMA-IN是后续自动栅压链路；本轮固定栅压检查无需此信号参与。
- OPA192保持原±5V供电，其SMA-OUT本轮不连接MOS G。

S相对公共GND会有分流电阻压降；万用表测VGS/VDS时黑笔直接接S。100kΩ下拉的偏置电流也流过分流电阻，后续电流比较需在相同栅压下取得近邻零点。

## 6. PCB资料的已知范围

现有图为2026-10-28的120×80mm布局参考，明确标注虚线不是铜线、仍需正式布线与DRC。它不能作为到货板网络已核实的证据。

- 中间：Q1=2N7000、漏极R1=1kΩ、栅极R2=1kΩ、G/S下拉R3=100kΩ。
- 左侧：RV1=10kΩ、SW1手动/自动选择、INA240外接接口J2/J14。
- 上侧：MCP4725接口J6、OPA电源接口J7、SMA IN/OUT J8/J9、漏极电源J10、±5V输入J13，以及模拟5V输入P1。
- 下侧：电流/栅压/漏压/源压采样输出，四路100Ω/1nF RC。
- 右侧：ADC数字J15、ADC模拟J16；左右边为AX7020扩展接口J20/J21。
- INA240的R100位于外部模块，不是本主板新增的分流电阻。

最终PCB的接插件针序、MOS封装方向、元件数值及供电网络，需要用户提供最终.epro2工程/原理图和到货板照片后核对。PCB到货不改变本轮台架的100.50Ω漏极电阻配置；迁移到板上另行记录。

本轮截止记录：output/dps/mos_cutoff_1V_20mA_20261101_145223.json。
台架状态记录：output/mos_scan/mos_bench_setup_20261101.json。
