wdzz8/ads8688-mos-test-platform/当前接线说明.txt

历史回环接线说明（2026-11-01提示）
本文件下文保留早期DAC/ADC回环配置；当前MOS固定栅压台架请看“当前台架完整接线_20261101.md”。
当前INA OUT接模块AIN8/芯片CH7，已完成基本截止检查；当前固件为mos_scan配对bit/ltx，不是下文的旧回环版本。

AX7020 + ADS8688 + MCP4725 原回环接线说明
============================================================
适用工程：ads8688_1
用途：MCP4725 输出三角波，ADS8688 采集 MCP4725 VOUT，使用 ILA 观察 ch_data。

一、供电与共地
------------------------------------------------------------
1. ADS8688 模块 AVDD/VCC：接 5V。
2. MCP4725 VDD：接 3.3V。
3. AX7020、ADS8688 模块、MCP4725 的 GND：必须连接在一起。
4. ADS8688 模块 DAISY：接 GND。
5. ADS8688 的模拟电源不要改接 3.3V；该模块按 5V 供电使用。
6. AX7020 J11-39/J11-40 的 3.3V 只作为测试电源使用，不要把它接到
   当前的 AIN0 回路上。

二、ADS8688 SPI 接线
------------------------------------------------------------
信号              ADS8688 模块端       AX7020 端          FPGA 端口
-----------------------------------------------------------------------
CS                CS                  J11-3              adc_cs_n
SCLK              SCLK                J11-4              adc_sclk
SDI               SDI                 J11-5              adc_sdi
SDO               SDO                 J11-6              adc_sdo
RST               RST                 J11-7              adc_rst_n

说明：
- AX7020 FPGA 管脚约束为：J11-3=F17，J11-4=F16，J11-5=F20，
  J11-6=F19，J11-7=G20。
- 当前工程使用 ADS8688 CH0（AIN0）采集。

三、MCP4725 I2C 接线
------------------------------------------------------------
信号              MCP4725 端          AX7020 端          FPGA 端口
-----------------------------------------------------------------------
SCL               SCL                 J11-9              mcp_scl
SDA               SDA                 J11-10             mcp_sda

1. J11-9 对应 FPGA 管脚 H18。
2. J11-10 对应 FPGA 管脚 J18。
3. SDA 和 SCL 各需要一个外部上拉电阻到 3.3V，推荐 2.2kΩ~4.7kΩ。
4. FPGA 端 I2C 为开漏方式：低电平由 FPGA 拉低，高电平由上拉电阻提供，
   不要把 SDA 直接设置成推挽高电平。
5. 当前程序默认 MCP4725 的 7 位 I2C 地址为 0x60，即写地址字节为 0xC0。
   该地址适用于 A0 接 GND 的常见模块；若模块 A0 电平不同，需要修改地址。

四、模拟回环接线（当前波形测试必须这样接）
------------------------------------------------------------
MCP4725 VOUT  ------------------>  ADS8688 AIN0
                                  模块接口 P2-4

1. VOUT 接 ADS8688 AIN0（P2-4）。
2. VOUT 接线前，先断开 AIN0 原来接 GND 或 AX7020 3.3V 的测试线。
3. 不要同时把 AIN0 接 GND、3.3V 和 MCP4725 VOUT，否则会发生电源冲突。
4. MCP4725 VOUT 先不要接 MOS 管栅极或其他偏置电路，先完成回环验证。
5. 用万用表测量时，黑表笔接公共 GND，红表笔接 MCP4725 VOUT；应缓慢在
   0V~3.3V 范围内上升、下降。

五、下载与 ILA 观察
------------------------------------------------------------
1. 下载文件：
   output/dac_adc_loopback/dac_adc_loopback.bit
   output/dac_adc_loopback/dac_adc_loopback.ltx
   bit 和 ltx 必须使用同一次生成的配对文件。

2. Vivado Hardware Manager 的 Tcl Console 执行：
   source scripts/capture_loopback.tcl

3. ILA 中观察：
   - ch_data：ADS8688 实际采集值；设置为 Radix=Unsigned、Waveform Style=Analog。
   - dac_applied：已经收到 ACK 并实际写入 MCP4725 的 DAC 码值。
   - init_done=1：ADS8688 初始化完成。
   - init_error=0：ADS8688 初始化回读无错误。
   - dac_ready=1：MCP4725 最近一次写入收到 ACK。
   - dac_error=0：MCP4725 没有检测到 NACK 错误。
   - capture_tick：每 1ms 保存一个 ILA 数据点。

4. 正常现象：
   - LED1/LED2 交替闪烁。
   - LED4 常亮。
   - LED3 常亮表示 ADS8688 初始化正常、MCP4725 已应答且无错误。
   - ch_data 应随 dac_applied 上升和下降，约看到 1.28s 周期的三角波。
   - ADS8688 ±10.24V 量程下，0V 附近约为 0x8000，3.3V 附近约为 0xA940。

六、故障排查顺序
------------------------------------------------------------
1. LED3 不亮：检查 ADS8688 5V、MCP4725 3.3V、共地、SDA/SCL 上拉和 A0 地址。
2. dac_error=1：优先检查 MCP4725 的 SDA、SCL、A0 和上拉电阻。
3. init_error=1：检查 ADS8688 的 CS、SCLK、SDI、SDO、RST 五根线。
4. dac_applied 变化但 ch_data 不变化：检查 VOUT 到 AIN0(P2-4) 的连接，
   并确认 AIN0 没有仍接 GND 或 3.3V。
5. ch_data 接近 0xFFFF：确认 ADS8688 模块仍使用 5V 供电，并检查 SDO、CS
   和公共地线。
