wdzz8/ads8688-mos-test-platform/标定与动态下一步_20261102.md

# 标定与低频动态：下一步

固定栅压输出曲线已经进入实物多曲线采集阶段。继续沿用自动扫描接线和电脑统一调度，不需要接 DG4102。当前因ADC反复全FFFF暂停标定，先定位运行时SPI/ADC状态，再补齐万用表参考和低频动态固件。

## 万用表参考

参考表为正点原子 DM40A。用户已按官方说明确认：USB 仅用于拷贝文件和固件升级，没有 COM 口。标定采用操作者在指定稳定电平下输入表上读数，同时记录实际单位、量程及分辨率；不修改万用表内文件。没有万用表实测数据之前，不修改绝对电压增益或宣称精度通过。

所有换笔、换档、移动测试夹均在 DPS 输出关闭状态完成；电压测量使用 DCV 档。继续保留板上 R1、INA 分流回路和当前地线。

1. 栅压：DPS OFF，固定 DAC 码，红笔 Q1-2 / VG，黑笔系统 GND；同时采 ADC CH0。至少记录低、中、高三个稳定电平。再量 VG 对 Q1-1 / VS，作为实际 VGS 对照。
2. 源压：DPS OFF 时红笔 Q1-1 / VS，黑笔系统 GND；同时采 ADC CH2。已有 CH2 的约 −13 mV 读数仅表明通道零偏尚未校准。当前分析中的源压扣零只扣除同一供电下的 DPS OFF 基线。
3. 漏压：固定低栅压、Q1 截止，DPS 从低压开始；红笔 Q1-3 / VD，黑笔系统 GND，同时采 ADC CH1。低压段及 1/2/3 V 应各保留 ADC 原码和万用表读数，结束逐点关闭 DPS。CH1 为 0～5.12 V 量程，零输入负偏可能被截到 0，不能简单把零码当作精确零点。
4. 电流交叉核对：分别量板上 R1 的实际电阻和带载压降，按 I=VR1/R1 对照 INA。R1 测阻必须全部断电且排除并联回路。现有约 990 Ω 为近似值；DPS 电压读回只有 0.01 V 分辨率，不能单独作为精密电流标定依据。

软件应分别保存原始值、基线、校准系数及参考仪器读数；不把重复性标准差当作绝对精度。

### 人工参考采集工具

`scripts/manual_voltage_calibration.py` 在 DPS 输出关闭条件下配对人工表读数和真实 ADC 数据。先准备低栅压参考点：

```powershell
python scripts/manual_voltage_calibration.py prepare --port COM3 --quantity VG --dac-code 256
```

成功时报告 `stage=awaiting_meter_reading`，输出本轮 `reference.json` 路径和 ADC 名义电压；操作者用直流电压档，红笔 Q1-2 / VG（也可用 J16-4）、黑笔公共 GND，回复完整显示读数及单位。该 ADC 预期值不是万用表实测值。

取得读数后运行 `record --report <本轮reference.json路径> --reading <显示数值> --unit <V/mV/uV>`，如已知量程则附加 `--meter-range <实际量程>`。工具先持久化人工读数，再采128行，核对 DAC 码和前后节点电压变化不超过2 mV，保存显示原文、单位、量程、两次原码/CSV及 ADC−DMM 差值。复采失败的人工读数仅作为未配对记录保留；重新初始化后须重新确认显示值。单点不会自动应用校准系数；当前 VD 功能只采 DPS OFF 零参考，带电漏压标定需另行安排。

若遇到全 FFFF 等无效采样，`prepare` 只在 DPS OFF 下重新初始化一次，并保留失败证据；若仍失败，不把该点交给操作者记录。

2026-11-02 首个 VG 点已完成参考配对：DAC256，用户读数204.65 mV，量程未提供；前后各128行，ADC名义均值194.578857 mV，ADC−DMM=-10.071143 mV，前后ADC变化-0.202637 mV，通过2 mV稳定性检查。报告为 `output/pcb1/manual_calibration/reference_20261102_182500_855068/reference.json`，stage=recorded。单点未应用校准系数。

第二个 VG 点用户报告2.0533 V，但18:38复采128行全部通道FFFF，报告 `output/pcb1/manual_calibration/reference_20261102_183216_822570/reference.json` 已标记failed，读数仅保留为未配对观察。全程DPS关闭、输出0 V、无保护。

18:40 在DPS OFF下重新初始化相同DAC2560，恢复后128行有效。用户确认仍为2.0533 V，但18:51复采再次全FFFF；`reference_20261102_184054_056034/reference.json` 已标记failed，人工读数仅保留为未配对记录。

### FFFF现场排查与当前参考

18:55在不重新下载的情况下读取物理配置状态，DONE、INIT_B和EOS均为1，CRC_ERROR为0，ILA扫描计数持续变化且VG码2560；同时128行ADC全FFFF。因此该次故障时FPGA程序在运行。ADS8688的init_done/init_error只反映启动过程，不能排除运行后掉电、复位或SPI连接异常。用户另用表确认模块AIN1为2.0533 V。现场证据为 `output/pcb1/adc_fault_diagnostic/run_20261102_185508/`。

重新下载同一镜像后，约97秒内连续三批384行有效，报告为 `output/pcb1/adc_fault_diagnostic/retention_20261102_185831/retention.json`；只能说明该观察窗口内采集恢复，FFFF根因尚未隔离。

已按用户要求重新编译并下载DAC2560。构建报告和旧镜像备份为 `output/pcb1/adc_fault_diagnostic/rebuild_20261102_190229/`，现有时序约束满足，仍存在既有调试/PS相关DRC警告及未完整约束的外部接口延时。新增 `scripts/fixed_vgs_device_status.tcl`，每次下载和采集检查并保存FPGA物理配置状态；ADC原码有效性独立检查。

第三次参考 `output/pcb1/manual_calibration/reference_20261102_190857_329719/reference.json`：重新编译下载后before为128行有效、ADC名义VG=2.044133301 V；用户再次报告2.0533 V，after又全FFFF，stage=failed，人工读数已保存为rejected。没有等待中的人工参考；DPS关闭、输出0 V、无保护。用户确认模块采用5 V供电，此为用户确认，未提供精确实测电压。

独立诊断使用 `rtl/mos_adc_diagnostic.v`：DAC固定2560，ILA记录SPI、初始化状态、连续FFFF计数及故障锁存；VIO仅重置ADC，不重写DAC。通过 `python scripts/run_adc_diagnostic.py program|capture|reset` 在DPS OFF下操作并保留前后证据。生产镜像和诊断镜像的LTX不能混用；实际下载状态见 `output/pcb1/bringup_state_20261102.json`。不将诊断数据接纳为标定点，不凭短时间正常宣称故障消除。

20:13 在诊断镜像复发现场实证单独复位ADC并重新初始化可恢复：1024个原始值从全FFFF恢复为全部有效，FPGA未重新下载，DAC未重写，复位计数0→1、故障锁存保留。SPI完整帧从`0000FFFF`恢复到正常数据，SDO不是整帧恒1。用户测模块RST为3.3 V。证据见[ADC故障排查_20261102.md](ADC故障排查_20261102.md)及`output/pcb1/adc_fault_diagnostic/reset_20261102_201343_288390/`；仍需定位触发原因。

## 固定 VDS 转移曲线

此前 1/2/3 V 数据是固定漏极电源下的栅压扫描；R1 导致实际 VDS 随 ID 变化。标准转移曲线还需要按实测 VD−VS 调整电源，保持目标 VDS。先完成可设定栅压和反馈调度，再记录达到目标 VDS 的点；当 3 V 电源上限或 R1 压降导致目标不可达时，应明确标记不可达，不能用固定电源扫描代替。

## 低频动态固件

已有 `mos_scan` 逐点稳定等待和 8 次平均适用于静态，不能直接作为动态波形。计划采用独立顶层：

- MCP4725 低/高电平交替，先做 1 Hz，再做 5/10 Hz；DPS 只提供稳定低压偏置，不承担定时脉冲。
- ADC 连续扫描，按完整通道组保存未平均 VG/VD/VS/INA；每组带 FPGA 时钟计数或时间戳，同时保留 DAC 实际完成标志。
- ADS8688 当前 SPI 为 1 MHz、帧间等待约 20 µs，多通道组间隔需要从 RTL 时间戳验证；各通道依次采样，不能当成四通道同时采样。
- 每轮先零电流参考，再有限时长带电采集，结束关闭并回读 DPS；异常和中断走同一关断路径。
- 该测试用于毫秒尺度低频响应。器件本征快速开关时间另需示波器和实际带宽验证。

动态固件、真实动态波形、精密标定和恒 VDS 转移特性目前仍未验收。
