wdzz8/ads8688-mos-test-platform/视频拍摄分镜_20261102.md

# MOS 管特性测试平台视频分镜

## 已生成的软件回放

`demo/mos_data_replay.mp4` 是由真实 PCB1 ILA CSV 重算结果生成的**数据回放视频**，用于展示曲线和算法流程。它不替代实物相机画面。

## 建议实拍顺序（约 90 秒）

1. **开场 8 秒**：拍 AX7020、PCB1、ADS8688 模块、DPS 和待测 2N7000 的全景；旁白说明 VG、VD、VS、ID 四类量测量。
2. **接线 12 秒**：固定镜头依次指向 J16 ADC 接口、MCP4725/OPA192 栅压链路、DPS 漏极供电；DPS 面板保持输出关闭。
3. **FPGA 10 秒**：屏幕录制 Vivado 下载 `output/mos_experiment/mos_experiment.bit` 和匹配 LTX，展示 ILA 有效行。
4. **静态测试 18 秒**：运行输出曲线采集，画面同时拍 DPS 电压和界面上的 VDS–ID 曲线；说明每点 128 行与关断回读。
5. **恒 VDS 18 秒**：展示栅压逐档变化、DPS 电压反馈和 VDS 接近 0.5 V；界面切换到转移曲线与 gm。
6. **动态测试 14 秒**：点击 1、5、10 Hz 回放按钮，说明 FPGA 每 416 µs 采一组 8 通道，通道时间差 364 µs。
7. **收尾 10 秒**：展示报告中的“名义电流系数、精密标定待补”和源代码目录；最后拍 DPS 输出 OFF 回读。

## 旁白中需要说清的边界

- 电流图是匹配 DPS OFF 基线加 INA240/分流器名义系数，当前用于比较和算法展示。
- 动态频率指标是整机采样系统的响应，不宣称 MOS 本征开关速度。
- Vth 是有限 VDS 和有限栅压范围下的趋势代理，不当作数据手册阈值电压。
