wdzz8/ads8688-mos-test-platform/vivado_handoff/接口预留与风险说明.txt

接口预留与风险说明
============================================================

一、DPS 电源模块
------------------------------------------------------------
当前工程没有 DPS 控制器，不能根据“USB 或串口”这几个字直接确定 FPGA 引脚。
硬件同学需要先提供：DPS 具体型号、接口板型号、连接器针脚定义、通信协议、
逻辑电平、波特率、是否隔离、是否需要 RTS/CTS、输出使能有效电平、故障输出
有效电平，以及电脑 USB 是否直接连接 DPS。

如果 DPS 是电脑 USB 设备：USB D+/D- 一般直接连接电脑，不应接 FPGA 普通 IO；
FPGA 与 DPS 的协调可以由上位机软件完成，当前工程无需新增 DPS FPGA 引脚。

如果 DPS 提供 3.3V TTL UART：建议逻辑信号为 dps_uart_tx 和 dps_uart_rx，
方向为 FPGA TX->DPS RX、DPS TX->FPGA RX；是否增加 dps_uart_rts/cts 由协议决定。

如果 DPS 是 RS-232 或 RS-485：必须使用对应收发器、端接和保护电路，不能把
RS-232/RS-485 线直接接到 AX7020 的 LVCMOS33 IO。收发器的 FPGA 侧才是
3.3V TTL，最终封装引脚需要根据收发器放置位置和 AX7020 J11 空闲针脚重新分配。

建议 DPS 预留的逻辑接口：
- dps_uart_tx：输出，DPS 参数设置/查询命令。
- dps_uart_rx：输入，DPS 返回数据。
- dps_enable：输出，电源输出使能；硬件应有上电默认关闭和故障关断。
- dps_fault：输入，过压/过流/过温等故障；有效电平待确认。
- ext_trigger_in：输入，外部开始扫描触发；当前未实现。
- scan_done：输出，一次扫描完成状态；当前未实现。

这些名称已经放入信号引脚表，但没有写入当前顶层 RTL，也没有加入 XDC，
因此当前 bit 不会驱动或采集这些信号。接口确认后要同步修改 RTL、XDC、
原理图、PCB 和测试脚本。

二、ADS8688
------------------------------------------------------------
- 模块 AVDD/VCC 使用5V；本工程实测验证也使用5V。
- AX7020 与模块数字信号为3.3V逻辑；ADS模块数字电源由模块实现，须按模块资料供电。
- DAISY 当前在模块端接GND，表示单器件使用；不分配FPGA IO。
- CH0/AIN0 为当前采样通道，MCP4725 VOUT 接模块 P2-4。
- 模块 AIN 输入上的串联电阻和电容属于滤波网络，不应按1:1分压计算。
- 当前设置的量程为±10.24V；名义上0V约对应0x8000，3.3V约对应0xA940，
  实际数值需考虑参考源、偏置、增益和输入网络误差。

三、MCP4725
------------------------------------------------------------
- VDD=3.3V，VSS=公共GND，A0默认接GND，程序使用7位地址0x60。
- SDA/SCL必须有到3.3V的上拉；FPGA侧采用开漏方式，不能推挽输出高电平。
- 当前只写易失DAC寄存器，不写EEPROM，避免连续扫描损耗EEPROM。
- VOUT先接ADS8688 AIN0验证，再接OPA192或MOS偏置前端；接入后必须重新核对
  输出负载、运放共模范围、保护电阻和ADC输入范围。

四、OPA192、INA240 和 MOS 模拟前端
------------------------------------------------------------
当前 Vivado 回环工程没有这些器件的数字控制端口。硬件设计时应另建模拟网络
并确认：
1. MCP4725 VOUT 是否直接作为VGS设定，还是先经OPA192缓冲/放大。
2. 第二路DAC如何产生VDS设定，以及正负电源和运放输出摆幅。
3. INA240的输入共模范围、增益版本、采样电阻功率和 Kelvin 走线。
4. MOS管漏极电流回路、采样电阻压降、INA240输出到ADS8688的保护和滤波。
5. OPA192、INA240输出不能超过ADS8688模块实际输入范围；所有模拟地和数字地
   的连接方式按模块手册与系统电流回路确定。
6. DPS故障时硬件应优先关闭功率输出，FPGA软件状态不能替代硬件保护。

五、PCB布局核对
------------------------------------------------------------
- ADS8688 AVDD、MCP4725 VDD、AX7020 IO电源分别按各自额定电压供电，并在器件
  电源脚附近放置去耦；具体电容值以芯片/模块资料和最终BOM为准。
- ADS8688 SPI线短且连续参考地，CS/CLK/SDI/SDO避免经过大电流MOS功率回路。
- I2C SDA/SCL靠近上拉电阻和连接器布线，避免长线和强干扰节点。
- MCP4725 VOUT到ADS8688 AIN0的模拟线远离开关电源节点；AIN0保持明确回路，
  不允许悬空。
- DPS功率地、大电流回路、INA240采样回路和ADC模拟地的回流路径需要在EDA中
  明确，不能只依靠“所有地铺在一起”解决。
- 所有外接线端建议增加ESD/过压保护；保护器件的漏电和钳位电压需符合ADC输入
  范围，不能直接套用普通USB保护方案。

六、交付前检查
------------------------------------------------------------
1. 核对CSV中的FPGA封装引脚与实际AX7020原理图版本。
2. 核对J11针号方向，确认J11-3~7、J11-9~10没有镜像或上下排误认。
3. 核对ADS模块5V供电和公共地，DAISY确实接模块GND。
4. 核对MCP4725 A0和上拉电阻，确认地址是否仍为0x60。
5. 不下载旧bit/ltx混合使用；必须使用同一版本的配对文件。
6. DPS接口型号确认后，补齐dps端口和引脚，再重新生成XDC和bit。
7. 上电顺序和故障关断由硬件同学确认，尤其是DPS输出接入MOS之前。
