wdzz8/ads8688-mos-test-platform/output/pcb1/fixed_vgs_20261102/family_20261102_173244/多栅压输出特性实测_20261102.md

# PCB1 多栅压输出特性实测（2026-11-02）

已完成四个固定栅压、每档七个漏极电源设定点（0.20/0.50/1.00/1.50/2.00/2.50/3.00 V）的真实测量。每点128行，共28点、3584个有效行。新增三档均由电脑在DPS关闭并回读后自动下载镜像、采零点、逐点开启/采集/关闭；DAC2560为本聊天前一轮数据，经原始CSV复核后合并。

## 实测范围与质量

- DAC 2432：源压扣零后VGS约 1.941094 V；名义ID范围 0.076599～0.112305 mA；全部行VG跨度 1.250 mV。
- DAC 2560：源压扣零后VGS约 2.044359 V；名义ID范围 0.166779～0.359039 mA；全部行VG跨度 1.875 mV。
- DAC 2688：源压扣零后VGS约 2.145810 V；名义ID范围 0.173035～0.934143 mA；全部行VG跨度 1.562 mV。
- DAC 2816：源压扣零后VGS约 2.247867 V；名义ID范围 0.192566～2.155762 mA；全部行VG跨度 1.875 mV。

新增三条曲线的每个点均保留DPS过程回读、结束关闭/0 V回读、原始CSV和ILA。三份新镜像构建均成功且满足现有时序约束；DRC仍有既有调试/PS基础设施相关警告。

## 电压和电流解释

旧图中的VGS约2.057 V来自VG−VS原始换算，含源压通道约−13 mV零偏；同轮DPS关闭基线扣除后约为2.044 V。当前合并图用扣除源压零点的VDS/VGS，CSV同时保留原始值、使用的源压基线和INA基线。该处理没有校准VG/VD通道的绝对零点或增益。

INA电流使用名义20 V/V与0.1 Ω。误差棒为行内重复性标准差，包含实际波动且不是绝对不确定度。R1≈990 Ω与DPS粗分辨率回读仅作交叉检查。低电流档与噪声接近，不能宣称已可靠测出漏电流或数据手册阈值。R1限制实际可达VDS，最高栅压曲线目前只到约0.874 V；不外推未覆盖的区段。

## 文件与复现

- 合并图：`analysis/fixed_vgs_output_curve.png`（同时保存SVG）。
- 合并原始换算表：`analysis/fixed_vgs_output_points.csv`。
- 完整分析与每条曲线来源：`analysis/fixed_vgs_output_analysis.json`。
- 多栅压调度报告：`family_report.json`。
- 完整采集脚本：`scripts/run_fixed_vgs_family.py`；分析：`scripts/analyze_fixed_vgs_family.py`。

自动采集命令：`python scripts/run_fixed_vgs_family.py --port COM3 --codes 2432 2688 2816 --build-missing`。运行会执行真实硬件操作；当前结果已保存，不需为浏览图而重跑。

已将10份RTL/XDC原样归入本项目`rtl/`和`constr/`，SHA256与相邻历史目录一致；构建和仿真脚本不再依赖相邻目录。41项Python测试以及ADS8688 SPI、MCP4725 I2C/波形/回环、mos_scan仿真通过。

下一步为DM40A参考标定、恒VDS转移特性及低频动态，整机尚未最终验收。

## 最终台架状态

DPS最终读回关闭、实际0 V，保留3.00 V/20 mA设定。FPGA已恢复DAC256。首次恢复后ADC出现全FFFF，保持DPS关闭并重新下载同一镜像后，`final_low_gate_retry.csv`复核128行有效、VG均值约0.194658 V；异常原文件保留并标为无效。此故障根因未隔离，不影响此前已核验的四条曲线文件。
