wdzz8/ads8688-mos-test-platform/demo/data/dynamic_waveforms.png

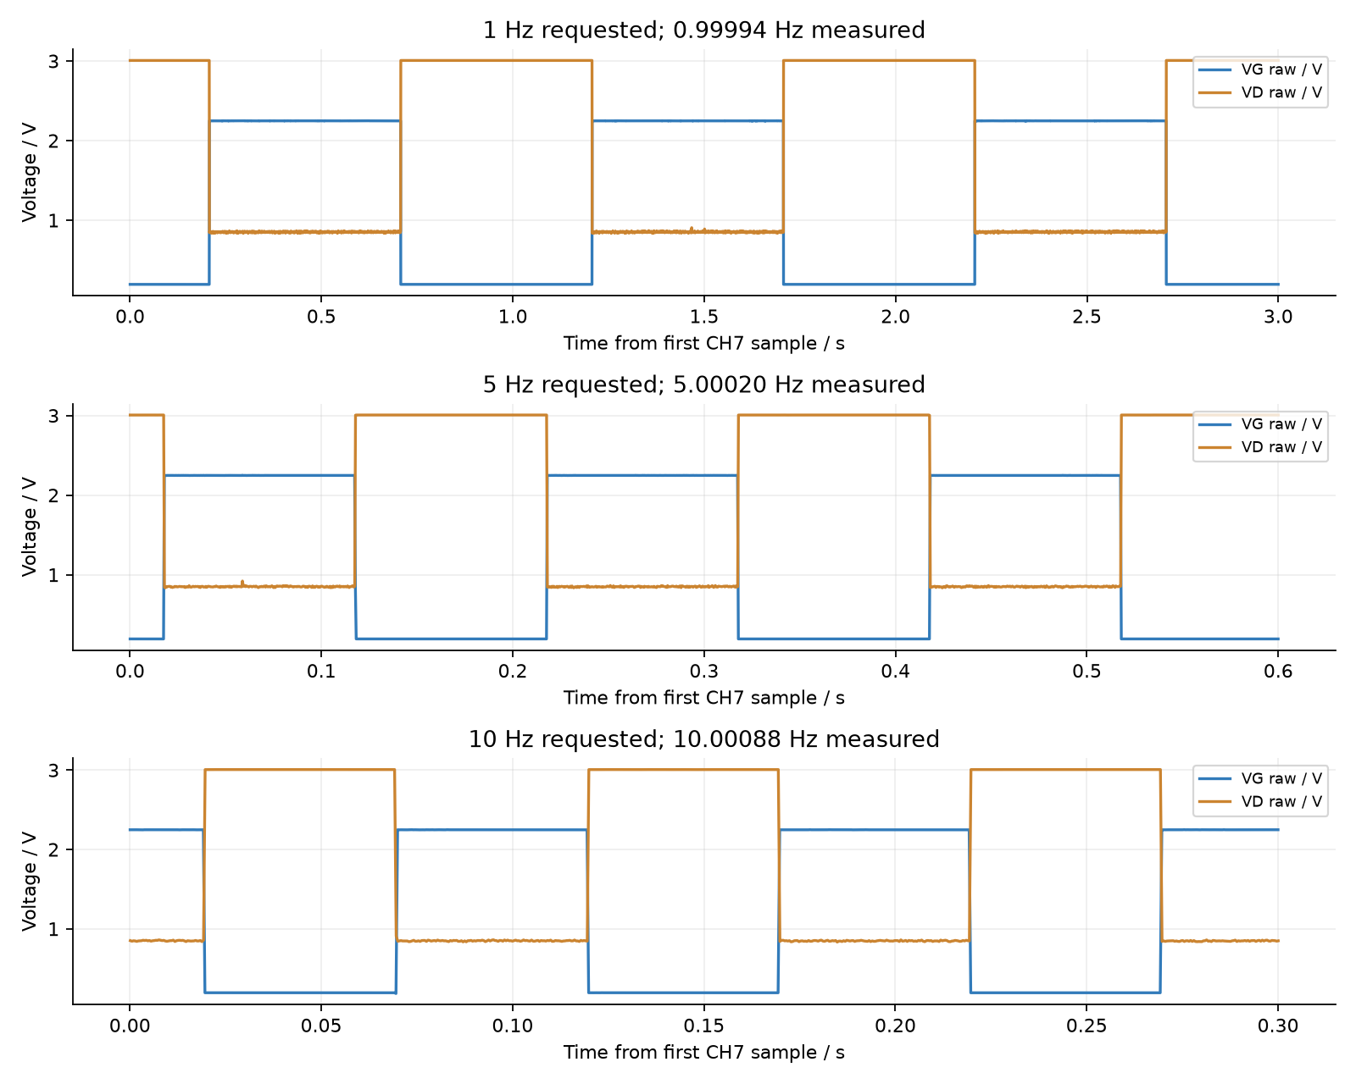
demo/data/dynamic_waveforms.png
