wdzz8/ads8688-mos-test-platform/demo/data/output_model.png

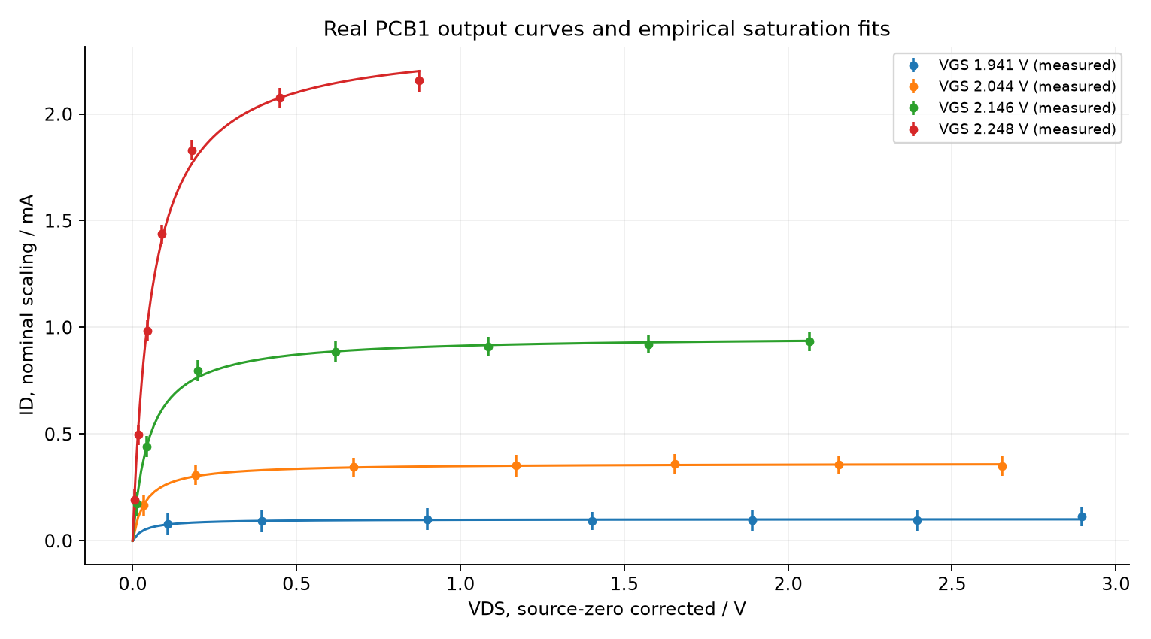
demo/data/output_model.png
