wdzz8/ads8688-mos-test-platform/demo/data/transfer_gm.png

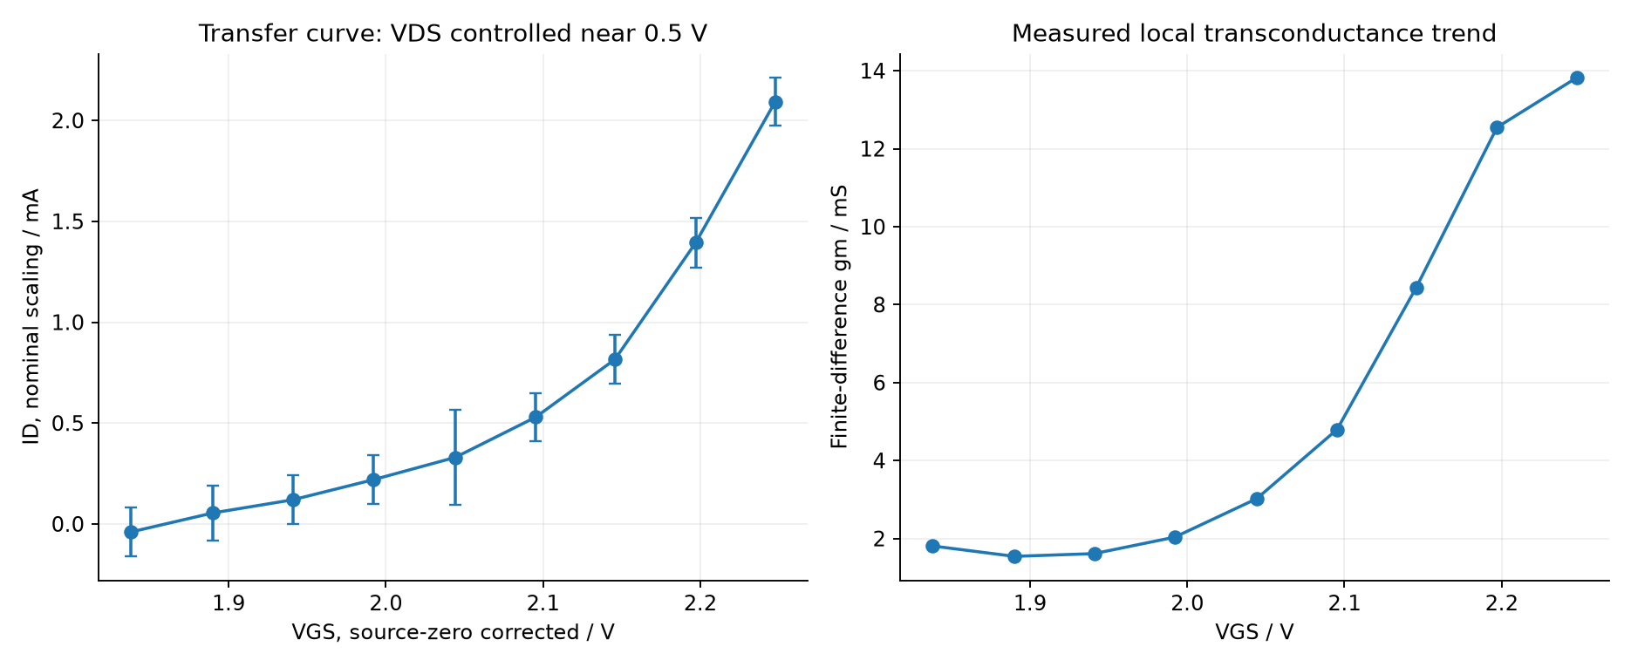
demo/data/transfer_gm.png
