wdzz8/ads8688-mos-test-platform/output/pcb1/fixed_vgs_20261102/family_20261102_173244/analysis/fixed_vgs_output_curve.png

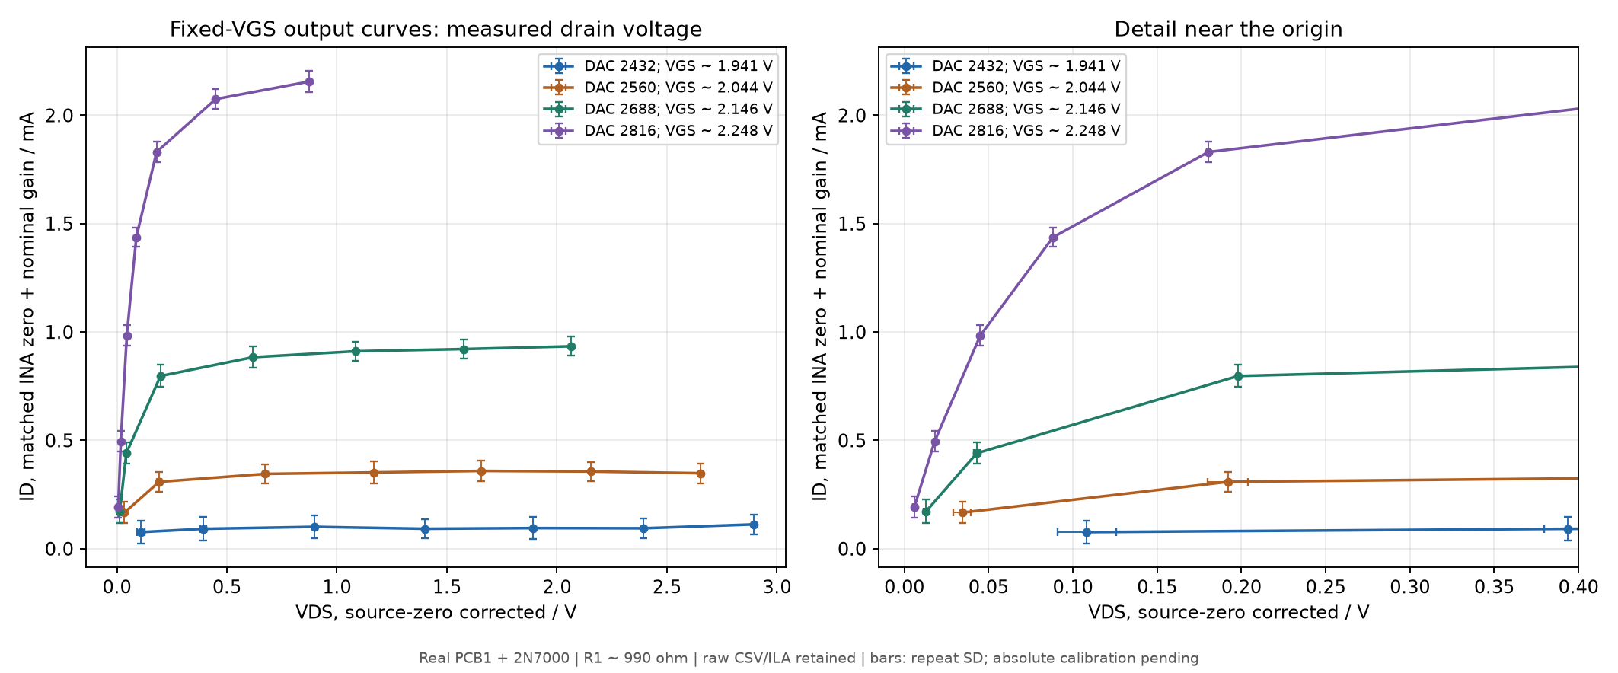
output/pcb1/fixed_vgs_20261102/family_20261102_173244/analysis/fixed_vgs_output_curve.png
