wdzz8/ads8688-mos-test-platform/全工程功能展示视频_拍摄执行清单.md

# 全工程功能展示视频拍摄执行清单

目标成片：约 3 分钟、横屏 16:9。手机拍实物，OBS 单独录电脑。现场不需要讲解或出镜，后期按画面锁定后制作 AI 普通话配音。

## 一、拍摄前准备

### 1. 设备和场景

- 按[当前PCB自动扫描接线_20261102.md](当前PCB自动扫描接线_20261102.md)中的已验证接线状态摆好台架。不要按早期回环或裸管接线图改线。
- AX7020、PCB1、ADS8688、MCP4725/OPA192、INA240、2N7000 与 DPS 尽量同框；擦净桌面和镜头，线缆自然整理，不遮住关键接口。
- 手机使用后置主摄、横屏、4K/30 fps；没有 4K 就用 1080p/30 fps。关闭美颜和滤镜，固定曝光与对焦，避免屏幕反光。
- 每段开始和结束都停稳 3 秒；实物特写每段录 10-15 秒。整机测试过程另录一条不中断的长视频。
- OBS 设置 1920×1080、30 fps，录屏文件先存 MKV，结束后用 OBS 的“文件 → 重新封装录制”转成 MP4。屏幕录制时关闭麦克风，避免后期 AI 配音与环境声混杂。
- 建议素材目录：`output/video_sources/01_phone`、`02_screen`、`03_photos`。原文件直接保存，不通过聊天软件压缩。

### 2. 台架和软件检查

先确认实际接线与上述状态一致，所有临时跳线、供电和 DPS 负端都按台架说明复核。不要为拍镜头临时拔线或制造 ADC 故障。

在项目 PowerShell 窗口执行：

```powershell
cd C:\Users\wdz\Desktop\fpga\ads8688_1
python scripts/dps_status.py ports
python scripts/dps_status.py status --port COM3 --baud 9600 --address 1
Test-Path output\mos_experiment\mos_experiment.bit
Test-Path output\mos_experiment\mos_experiment.ltx
Test-Path D:\FPGAvivado\Vivado\2022.2\bin\vivado.bat
```

确认 COM3 是 DPS3005，回读状态为 `output_enabled: false`、`voltage_out_V: 0.0`，三个 `Test-Path` 都返回 `True`。退出会占用 COM3 的其它程序；Vivado Hardware Manager 不要同时占用同一块 JTAG 设备。

历史结果可双击 `demo/index.html` 离线查看。要让网页显示本次实时采集，先在一个 PowerShell 窗口运行 `python scripts/live_demo_server.py`，浏览器打开 `http://127.0.0.1:8765/demo/index.html`，再在另一个 PowerShell 窗口运行测试脚本。进入“实时实测”页；恒 VDS 每次反馈写入后更新，动态测试在每档 ILA CSV 落盘后显示原始 VG/VD、频率和占空比。运行编号、报告路径、更新时间和失败状态均取自本次原始报告。服务只读报告，不操作仪器。历史数据仍为 3,584 行固定 VGS 输出、24,576 组动态数据和 9 个恒 VDS 点；页面不会用历史数据填充本次实时曲线。

下面命令框中只复制命令本身，不要复制 ` ```powershell`、` ```python` 或结尾的 ` ``` `。命令一行一行执行，看到提示符回来再输入下一条。

## 二、现场实物拍摄

每个镜头拍两遍，手机固定；不要一边手持走动一边变焦。

1. 整机斜侧全景 15 秒：AX7020、PCB1 和仪器都入画，作为开场和封面。
2. 正上方全景 10 秒：完整展示测试台和实际接线。
3. PCB1/2N7000 特写各 10 秒：型号、接口和测试器件清楚对焦。
4. FPGA/ADS8688、MCP4725/OPA192、INA240 分别特写各 8-10 秒：用来后期标注采样、栅压与电流检测路径。
5. 手部操作 10 秒：自然地点击启动、操作鼠标或按实际流程操作电源，不用看镜头。
6. 完整测试过程：手机固定同框拍摄，至少覆盖运行前、采集进行中和结束后的 DPS 关闭状态。另用 OBS 录同一过程的电脑操作，开始时轻敲桌面一次作为同步点。
7. 结束关断镜头 15 秒：拍 DPS 输出关闭显示，并用只读状态命令回读确认。

## 三、电脑录屏与现场动态采集

### 现场真实性镜头（优先拍）

1. 手机固定拍到板卡、DPS 和电脑屏幕；OBS 同时录屏。保留完整连续原片。
2. 打开 `http://127.0.0.1:8765/demo/index.html?tab=live`，先拍清最近报告的编号、更新时间和状态。服务每秒检查报告；测量值在 ILA 批次完成后更新，不能讲成连续流式波形。
3. 按下文流程启动一次新的采集。画面保留命令输入、新运行编号出现、已验收点/频率档增加和电源读数。若数据没有变化，如实等待，剪辑加速时标明“加速”，不要用历史曲线渐显冒充现场采集。
4. 新采集完成后，从其中一个表格行打开对应 ILA CSV，再打开原始报告，对照 DAC/频率档、文件路径和时间；最后拍 DPS OFF 与只读状态回读。
5. 答辩时可让老师在已验证的 1、5、10 Hz 中任选一档，再执行单档动态测试，核对页面从 CSV 算出的实测频率。参数仍使用下文已验证范围。文件路径本身不能证明现场测量，连续镜头和现场选参复测才是关键。

若继续 2026-11-03 的失败恒 VDS 测量：该报告仅 3/9 点通过，日志显示 FPGA DONE=0。应先按下面 Vivado 步骤重新下载配对 bit/LTX，确认成功并释放 Hardware Manager，再启动新测量。要拍“从空白逐点形成曲线”，使用新测量，不使用 `--resume`；续测页会明确标出历史继承来源。

### A. 录 Vivado/工程证据

用 OBS 录屏，打开项目中的 `output/mos_experiment/`，展示同目录配对的 `mos_experiment.bit` 和 `mos_experiment.ltx`；随后打开 PC 平台的“FPGA 工程”页，停留到时序和资源数据可读。若在 Vivado Hardware Manager 里展示已下载镜像和 ILA 波形，下载后不要同时启动 Vivado 手动 ILA 采集；运行下面的脚本时由批处理 Vivado 控制同一设备。镜头应显示实际文件或采集结果，不用静态宣传图代替。

### B. 跑一次真实动态采集

开录之前重新运行 DPS 只读状态检查，确认输出关闭。OBS 同时录桌面，手机固定拍板卡和 DPS。然后执行：

```powershell
python -u scripts/run_mos_demo.py --port COM3 --frequencies 1 5 10 --voltage 3 --low-code 256 --high-code 2816
```

该命令会自动使用并下载 `output/mos_experiment/mos_experiment.bit/.ltx`，先做低栅压检查，再依次采集 1、5、10 Hz；DPS 设定上限为 3 V、20 mA，脚本在每轮之后及结束时都执行输出关闭回读。运行期间不要操作或拔插台架，等待程序结束并看到报告路径及最终关断记录。

每个频率结束时应看到类似 `DYNAMIC 1 Hz: 8192 rows; drain OFF` 的日志。完整采集可能需要数分钟，剪片时只需保留每档启动、波形采集中的短镜头和该档完成日志；原始完整录像留作备份。若脚本报错，保留错误和现场日志，不要连续重跑或用不完整数据作结果。

### C. 可选：再跑一次恒 VDS 闭环

只有动态采集已正常完成、DPS 再次确认关闭、台架没有改线时才执行。动态采集会自动下载 `mos_experiment.bit/.ltx`，因此可以直接接着做恒 VDS。若没有刚成功运行动态采集，先在 Vivado Hardware Manager 里手动下载配对镜像：连接 AX7020 → 选中 XC7Z020 → Program Device → Bitstream 选 `output/mos_experiment/mos_experiment.bit` → Debug Probes 选同目录 `mos_experiment.ltx` → Program。看到下载成功后关闭 Hardware Manager，再运行下面命令；不要让 Vivado GUI 和脚本同时占用 JTAG。

恒 VDS 会对 9 个 DAC 码（2304 到 2816，步进 64）逐点调节漏极电源，目标 VDS 为 0.500 V、接受误差 ±0.015 V。每个候选点都执行采集与关断回读，时间明显长于动态测试：

```powershell
python -u scripts/run_transfer_curve.py --port COM3
```

录下终端中的 `VGS`、`VDS`、名义电流和 `OFF` 回读。展示时称为“上位机闭环反馈”或“恒 VDS 测试”，不要说成 FPGA 内部高速伺服。若时间有限，直接在离线平台展示已有 9 个实测点即可，无需重跑。

### D. 更新离线展示（仅在本次动态采集成功后）

本次恒 VDS/动态采集会直接在“实时实测”页更新，不需要先运行离线 bundle 构建。若还要刷新历史分析页，再运行：

```powershell
python scripts/analyze_experiments.py
python scripts/intelligent_analysis.py
python scripts/build_engineering_report.py
python scripts/build_demo_bundle.py
```

确认命令成功后，双击 `demo/index.html`。OBS 录以下导航，每页停留 5-8 秒，鼠标移至空白处：

1. “总览”：显示有效数据量和三类实验结果。
2. “输出特性”：四条固定 VGS 曲线和留一点评估。
3. “转移 / gm”：9 个 VDS 回读点和 gm。
4. “动态回放”：依次点 1、5、10 Hz，各停 5 秒。
5. “质量门控”：显示数据检查、闭环窗口和限制项。
6. “采样建议”：说明这是规划建议，需重新实测后才进入结论。
7. “FPGA 工程”：显示实现时序、失败端点和资源。
8. “复现与结论”：短暂停留后回总览，结束录屏。

固定栅压输出曲线的四档全量重采需要多次下载固定栅压镜像和逐点控制 DPS，不建议为拍片临时重跑；使用平台里基于原始 CSV 生成的已有真实曲线，并在片中标注“离线实测数据回放”。

## 四、三分钟剪辑时间线

| 成片时间 | 画面 | 关键信息 |
|---|---|---|
| 0:00-0:12 | 整机斜侧主视觉，缓慢切到 MOS 特写 | FPGA 闭环参数测试平台 |
| 0:12-0:35 | PCB、AX7020、ADC、栅压和检测链路特写，叠加简洁标签 | FPGA 负责确定性采集，主机负责编排和分析 |
| 0:35-0:50 | Vivado 文件/ILA 证据和 FPGA 工程页 | 50 MHz 目标时钟、8 通道、实现报告 |
| 0:50-1:20 | PC 平台输出特性页，实测点逐渐出现 | 4 个固定栅压、7 个 VDS 点、每点 128 行 |
| 1:20-1:45 | 恒 VDS 曲线、VDS 接受窗口和仪器镜头 | 9 点进入 0.500 V ± 15 mV 窗口 |
| 1:45-2:15 | 实物运行与终端日志交叉剪辑，再切 1/5/10 Hz 动态回放 | 每档 8,192 组；整机系统响应 |
| 2:15-2:38 | 质量门控、诊断日志、OFF 回读 | 时间戳、坏行、闭环窗口和关断证据 |
| 2:38-2:52 | 资源/时序页及 bit/LTX 文件 | WNS 7.640 ns、WHS 0.048 ns、失败端点 0 |
| 2:52-3:00 | 台架全景，DPS OFF，项目名称收尾 | 真实数据、可复现工程、限制如实标注 |

片中全程保留清楚的图表坐标与小字，不要加大量粒子、霓虹 HUD、快速推拉或 AI 生成芯片画面。用实物、仪器显示、鼠标操作、数据点和真实日志建立可信度；音乐只做轻铺底，避免压住配音。

## 五、后期 AI 配音稿

画面初剪锁定后再生成配音，使用自然、克制的普通话技术解说音色，语速约每分钟 220-250 字；按句子分段生成，留出停顿。校对 AX7020、ADS8688、MCP4725、VDS、VGS、WNS、WHS 的读音。可直接使用以下稿子，再按剪辑删改：

> 一次可靠的器件测试，不只需要一条曲线，还需要每个测量点背后的采集依据。
>
> 本平台以 AX7020 FPGA 为采集控制核心，协调栅压输出、漏极电源和八通道 ADC。FPGA 保留采样时序与状态标记，上位机负责测试编排、反馈调节和数据分析。
>
> 在固定栅压输出测试中，系统覆盖四档栅压和七个漏极电压点，每点保存一百二十八行采样。图中的圆点来自 PCB 实测，虚线是用于比较的经验模型，并通过留一点验证。
>
> 恒漏源电压测试采用逐点反馈。系统读取实际 VDS，调整电源，再判断测量点是否进入目标窗口。九个转移点都落在零点五伏正负十五毫伏范围内。这里展示的是上位机反馈流程。
>
> 动态测试分别请求一、五和十赫兹，每档保存八千一百九十二组有效数据。八个通道按顺序采样，因此结果描述整机采集系统响应，不代表 MOS 管本征开关速度。
>
> 采样序号、时间戳、通道切换和异常行状态共同构成质量门控依据。每轮测试结束后，漏极电源关闭状态会再次回读并记录。
>
> 当前工程已完成时序收敛，失败端点为零，并交付匹配的 FPGA 配置文件和逻辑分析探针文件。电流仍按名义系数换算，精密标定、异常根因和独立硬件关断还需继续验证。我们让每项结果都能追溯到数据和实现证据。

## 六、交付素材核对

- 手机原始视频：整机、接线/板卡特写、完整动态测试、DPS 关断。
- OBS 录屏：Vivado/ILA、动态采集日志、PC 平台功能导航。
- AI 配音 WAV 或高码率 MP3、背景音乐授权来源。
- H.264 MP4 成片、SRT 字幕、项目文件或可复现导出设置。
- 片尾与说明保留边界：名义电流、系统动态响应、Vth 趋势代理、FFFF 根因待查、独立硬件保护未完成验证。
