wdzz8/ads8688-mos-test-platform/通道映射记录.csv

输入位置 | 文档标注 | ADS8688候选通道 | 实测施加电压 | adc_ch0 | adc_ch1 | adc_ch2 | adc_ch3 | adc_ch4 | adc_ch5 | adc_ch6 | adc_ch7 | 确认结论 | 备注
J16-3 | ADC_ID 模块AIN8 | CH7（芯片AIN7/P2-3） |  |  |  |  |  |  |  |  |  | 模块资料对应关系已核对；PCB走线待实测 | 模块丝印从AIN1开始编号
J16-4 | ADC_VG 模块AIN1 | CH0（芯片AIN0/P2-4） |  |  |  |  |  |  |  |  |  | 模块资料对应关系已核对；PCB走线待实测 | 对应栅极电压候选
J16-5 | ADC_VD 模块AIN2 | CH1（芯片AIN1/P2-5） |  |  |  |  |  |  |  |  |  | 模块资料对应关系已核对；PCB走线待实测 | 正式接漏压前需核对CH1量程
J16-6 | ADC_VS 模块AIN3 | CH2（芯片AIN2/P2-6） |  |  |  |  |  |  |  |  |  | 模块资料对应关系已核对；PCB走线待实测 | 对应源极电压候选
MCP4725 VOUT | 历史直接回环 | CH0（模块AIN1/P2-4） |  |  |  |  |  |  |  |  |  | 早期直接回环已通过 | 当前单路送OPA输入；用户无法分路并采用分次采集
OPA192 SMA-OUT | 152344接AIN1及152527接AIN2 | CH0（P2-4）/CH1（P2-5） |  |  |  |  |  |  |  |  |  | 两路32点阶梯一致性检查通过 | 非零点CH1较CH0平均高9.256mV；分次采集含时间漂移；OPA输出现接AIN2
INA240 OUT | 190312/192736第二点及零点已配对 | CH7（模块AIN8/P2-3） | 电流点2.593905487V；新临时零点2.499066086V |  |  |  |  |  |  |  | 31988.0458984375 | 5/50mA基本响应已核对；精确增益待验证 | 参考49.582mA；供电4.990V/4.999V；条件性参考修正49.670mA；不等于精度指标；临时零点已更新；增益仍名义20
