wdzz8/ads8688-mos-test-platform/ADC故障排查_20261102.md

# ADS8688 运行中全 FFFF：现场与恢复证据

本记录只确认观察窗口中的状态和恢复效果，触发原因尚未隔离。DPS 全程通过 COM3 关闭并回读输出 0 V，没有应用新的标定系数。

## 已确认的现场

- 生产固定栅压 DAC2560 镜像三次在人工参考复采时出现全通道 FFFF，包含完整重新编译下载后的第三次。`reference_20261102_190857_329719/reference.json` 为 failed，2.0533 V 保留为 rejected；当前没有等待中的人工参考。
- 用户用万用表测模块 AIN1 为 2.0533 V；确认模块使用 5 V 供电，但没有给出精确供电实测数值。之后按直流电压档、模块 GND 为参考，用户报告模块 RST 为 3.3 V，量程未提供。当前高电平不能排除此前的短脉冲。
- 物理配置检查 DONE、INIT_B、EOS 为 1，CRC_ERROR 与 IDCODE_ERROR 为 0；ADC 采样计数和通道索引仍推进。启动标志 init_done=1、init_error=0 不能作为运行时健康判断。

## 独立诊断镜像

顶层为 `rtl/mos_adc_diagnostic.v`，固定 DAC2560，启动时只写一次 DAC。VIO 仅复位 ADC 控制器，并执行模块 RST/PD 复位及原初始化序列；不重写 DAC。连续至少 16 个 FFFF 置位故障锁存，故障锁存及复位计数跨 ADC 复位保留。

实际下载文件：`output/mos_adc_diagnostic/code_2560/mos_adc_diagnostic.bit`，必须配同目录 LTX。SHA256：`a498d26d6b31c3c6f417585ee9189ea46033e63ecb0a62734c8b47c3c1d4d221`。这不是自动栅压扫描文件，也不用于接受标定点。

构建 0 错误、0 严重警告，现有约束 WNS=10.944 ns、WHS=0.048 ns；5 项调试/PS 相关 DRC 警告仍在，外部接口延时未完整约束。ADS8688 SPI 回归（含外部重初始化）及 mos_scan 仿真已通过，人工参考工具 4 项测试通过。

## 实机观察与单独复位

19:29 下载后，1024 个未平均 ADC 原始值有效，每通道 128 个。19:32、19:38 开始的两段 VIO 观察分别为 300.524 s、180.177 s，结束的两批各 1024 个原始值均无 FFFF。后续发现 VIO INPUT_VALUE 与 ILA 实际信号不一致，因此撤回这两段及20:16那段VIO日志的连续健康证据资格，仅保留各次真实ILA采样的结论；原始日志不删除。

20:13 在未重新下载 FPGA 的情况下再次采集，故障已复发。证据目录：`output/pcb1/adc_fault_diagnostic/reset_20261102_201343_288390/`。

1. `before_words.csv` 的 1024/1024 个采样全为 FFFF，每通道 128 个，ffff_run 已饱和 65535，fault_latched=1，adc_reset_count=0。
2. `before_spi.csv` 连续 4096 个 50 MHz 时钟样本，共 81.90 µs；CS/SCLK 仍变化、RST=1。完整 32 位帧为 SDI=`00000000`、SDO=`0000FFFF`，所以这段现场不是整帧 SDO 恒 1。
3. 通过 VIO 执行一次 ADC-only reset，没有重新下载 FPGA；之后 adc_reset_count=1，fault_latched 仍为 1。
4. `after_words.csv` 的 1024 个原始值全部恢复有效、无 FFFF，每通道 128 个，ffff_run=0，init_done=1、init_error=0、dac_ready=1、dac_error=0。CH0 名义均值 2.044096680 V，未与旧万用表读数重新配对。
5. `after_spi.csv` 完整帧示例 SDI=`00000000`、SDO=`00009BAC`；相邻通道采样间隔 52.0 µs，通道顺序正常。

这证明该次故障可以通过 ADC 复位加重新初始化恢复，不能证明永久解决，也不能区分 ADC 状态、寄存器变化、参考源、瞬态供电和物理链路触发等原因。复发时间只能限定在最后正常观察之后、20:13 采集之前，不能精确定位。

## 继续操作

```powershell
python scripts/run_adc_diagnostic.py capture
python scripts/run_adc_diagnostic.py observe --seconds 300
python scripts/run_adc_diagnostic.py reset
```

工具会先确认 DPS OFF，保留原始 CSV、FPGA 配置、VIO 观察和前后电源回读；reset 先取现场再复位。observe 在已有故障锁存为 1 时，监测新的连续 FFFF，避免将历史故障误报为新故障。当前镜像没有自动恢复，便于保留触发现场。

## 20:48 寄存器读取与监测修正

新增可选只读寄存器审计，默认关闭，不影响生产顶层的采集流程。运行中收到请求后在完整帧之间读12个寄存器：3F、01、02、03、05～0C；读后CS保持高、暂停ADC采样，直到显式ADC复位。审计不写配置、不重置ADC、不把寄存器回复当转换数据。SPI回归新增审计用例，校验12个字节、帧长、无复位、暂停保持以及复位恢复；8种SPI案例及mos_scan回归均通过。

当前实际镜像已切至 `output/mos_adc_diagnostic/audit_code_2560/mos_adc_diagnostic.bit`，配同目录LTX；旧code_2560镜像保留。最终构建WNS=10.893 ns、WHS=0.057 ns，bus skew约束满足，0错误、0严重警告，仍有5项调试/PS DRC警告，外部接口延时未完整约束。镜像SHA256以最新编程报告和bringup_state为准。

首次实机通过VIO输入轮询完成标志出现超时，但后续ILA实证读取已经完成并暂停，说明VIO输入值不能作为该控制路径的可靠依据。20:48修改为ILA直接保存完成标志和96位寄存器结果，成功取得正常对照：01=FF、02=00、03=00，05～0C依次为00/06/00/06/00/00/00/06。3F=00，对应最近的NOP命令，不能单独证明工作模式。证据：`output/pcb1/adc_fault_diagnostic/audit_20261102_204806_465603/`。

20:49显式ADC复位后1024个原始值有效。此后 `observe_audit` 用ILA原始快照检查故障锁存和FFFF计数，每次轮询CSV保存在polls目录；历史文件名vio_observation.csv继续使用，但新报告source明确标识ILA。发生故障时先保存完整SPI及1024原码，再只读配置并暂停，不自动复位。20:49开始的300.832秒ILA观察没有触发故障，结束1024个原始值有效；这不证明永久恢复。

```powershell
python scripts/run_adc_diagnostic.py observe_audit --seconds 300
python scripts/run_adc_diagnostic.py audit
python scripts/run_adc_diagnostic.py reset
```

若再次故障，先保留SPI、原码和配置，并在复位前核对模块实际DVDD/参考源。单独复位恢复与寄存器一致都不能代替触发原因定位，也不能作为精度验收依据。
