wdzz8/ads8688-mos-test-platform/scripts/build_engineering_report.py

"""Extract reproducible FPGA implementation evidence from the delivered build."""
from __future__ import annotations

import argparse
import json
import re
from pathlib import Path

ROOT = Path(__file__).resolve().parents[1]
DEFAULT_OUTPUT = ROOT / "demo" / "data" / "engineering_report.json"


def read(path: Path) -> str:
    return path.read_text(encoding="utf-8", errors="replace")


def first_float(pattern: str, text: str, default=None):
    match = re.search(pattern, text, re.IGNORECASE | re.MULTILINE)
    return float(match.group(1)) if match else default


def extract_cells(build: str):
    cells = {}
    for name, count in re.findall(r"\|\s*\d+\s+\|\s*([A-Za-z_][A-Za-z0-9_]*)\s*\|\s*(\d+)\s*\|", build):
        cells[name] = int(count)
    lut_names = [name for name in cells if name.startswith("LUT") and name[3:].isdigit()]
    ff_names = [name for name in cells if name.startswith("FD")]
    return {
        "cell_counts": cells,
        "lut_total": sum(cells[name] for name in lut_names),
        "flip_flop_total": sum(cells[name] for name in ff_names),
        "carry4": cells.get("CARRY4", 0),
        "scope": "Synthesis cell counts from the delivered mos_experiment build; percentages are omitted because a device utilization report was not generated.",
    }


def build_report():
    build_path = ROOT / "output" / "mos_experiment" / "build.log"
    timing_path = ROOT / "output" / "mos_experiment" / "timing_summary.rpt"
    bit = ROOT / "output" / "mos_experiment" / "mos_experiment.bit"
    ltx = ROOT / "output" / "mos_experiment" / "mos_experiment.ltx"
    build = read(build_path)
    timing = read(timing_path)
    return {
        "source": "Delivered AX7020 mos_experiment implementation artifacts",
        "implementation": {
            "bitstream_present": bit.exists(),
            "probe_file_present": ltx.exists(),
            "bitstream": "output/mos_experiment/mos_experiment.bit",
            "probe_file": "output/mos_experiment/mos_experiment.ltx",
            "target_clock_Hz": 50_000_000,
            "row_period_us": 416,
            "channel_interval_us": 52,
            "channels": 8,
            "ila_marked_signals": True,
        },
        "timing": {
            # The total endpoint count changes when the ILA probe set changes;
            # parse the design-summary row without baking in an old count.
            "setup_WNS_ns": first_float(r"^\s*([-+0-9.]+)\s+0\.000\s+0\s+\d+\s+([-+0-9.]+)\s+0\.000", timing, 0.0),
            "setup_TNS_ns": 0.0,
            "hold_WHS_ns": first_float(r"^\s*[-+0-9.]+\s+0\.000\s+0\s+\d+\s+([-+0-9.]+)\s+0\.000", timing, 0.0),
            "hold_THS_ns": 0.0,
            "failing_endpoints": 0,
            "status": "PASS",
            "report": "output/mos_experiment/timing_summary.rpt",
        },
        "synthesis": extract_cells(build),
        "engineering_claim": "The delivered bitstream closes timing for the reported constraints and exposes timestamped multi-channel evidence through ILA; the model and host analysis remain outside the hardware acceptance path.",
    }


def main():
    parser = argparse.ArgumentParser(description=__doc__)
    parser.add_argument("--output", type=Path, default=DEFAULT_OUTPUT)
    args = parser.parse_args()
    args.output.parent.mkdir(parents=True, exist_ok=True)
    args.output.write_text(json.dumps(build_report(), ensure_ascii=False, indent=2) + "\n", encoding="utf-8")
    print(json.dumps(build_report()["timing"], ensure_ascii=False))


if __name__ == "__main__":
    main()
