wdzz8/ads8688-mos-test-platform/rtl/mos_experiment.v

`timescale 1ns / 1ps
// PCB1 host-controlled fixed gate / low-frequency square-wave experiment.
// Each row is one unaveraged, sequential 8-channel sweep. No drain control.
module mos_experiment #(parameter integer CLK_FREQ=50_000_000)(
    input wire sys_clk, input wire adc_sdo,
    output wire adc_cs_n, adc_sclk, adc_sdi, adc_rst_n,
    inout wire mcp_sda, output wire mcp_scl, output wire [3:0] led
);
    reg [15:0] por_count=0;
    wire por=!por_count[15];
    always @(posedge sys_clk) if (por) por_count<=por_count+1'b1;
    wire [11:0] request_low, request_high;
    wire [31:0] request_half_cycles;
    wire request_wave, request_apply, request_adc_reset;
    (* mark_debug="true" *) wire [15:0] adc_data;
    (* mark_debug="true" *) wire [2:0] adc_index;
    (* mark_debug="true" *) wire adc_valid, init_done, init_error;
    ads8688_top #(.EXTERNAL_RESET_ENABLE(1), .RANGE0(0), .RANGE1(6),
        .RANGE2(0), .RANGE3(6), .RANGE4(0), .RANGE5(0), .RANGE6(0), .RANGE7(6)) u_adc(
        .sys_clk(sys_clk), .restart(request_adc_reset), .audit_request(1'b0),
        .adc_cs_n(adc_cs_n), .adc_sclk(adc_sclk), .adc_sdi(adc_sdi),
        .adc_sdo(adc_sdo), .adc_rst_n(adc_rst_n), .ch_data(adc_data),
        .ch_index(adc_index), .ch_valid(adc_valid), .init_done(init_done),
        .init_error(init_error), .reg_readback()
    );
    reg [11:0] low_code=256, high_code=256;
    reg [31:0] half_cycles=25_000_000, phase_cycles=0;
    reg wave=0, phase=0, previous_apply=0;
    (* mark_debug="true" *) reg [15:0] configuration_id=0;
    wire apply=request_apply && !previous_apply;
    wire [11:0] requested_code=phase ? high_code : low_code;
    // This is a PL-side gate-voltage fallback request.  It commands the
    // existing MCP4725 path to code 0; it is not an independent analog clamp.
    (* mark_debug="true" *) reg safe_gate_requested=0, safe_gate_zeroed=0;
    wire [11:0] desired_code=safe_gate_requested ? 12'd0 : requested_code;
    always @(posedge sys_clk) begin
        previous_apply<=request_apply;
        if (por) begin
            low_code<=256; high_code<=256; half_cycles<=25_000_000;
            phase_cycles<=0; wave<=0; phase<=0; configuration_id<=0;
        end else if (apply) begin
            low_code<=request_low; high_code<=request_high;
            half_cycles <= request_half_cycles < CLK_FREQ/1000 ? CLK_FREQ/1000 : request_half_cycles;
            phase_cycles<=0; phase<=0; wave<=request_wave;
            configuration_id<=configuration_id+1'b1;
        end else if (wave && init_done && !init_error) begin
            if (phase_cycles>=half_cycles-1) begin
                phase_cycles<=0; phase<=!phase;
            end else phase_cycles<=phase_cycles+1'b1;
        end else begin phase_cycles<=0; phase<=0; end
    end
    reg dac_start=0, have_code=0;
    reg [11:0] dac_set=256;
    wire dac_done, dac_ack_error;
    (* mark_debug="true" *) wire dac_busy;
    (* mark_debug="true" *) reg dac_ready=0, dac_error=0;
    (* mark_debug="true" *) reg [11:0] vg_code=256;
    (* mark_debug="true" *) reg [31:0] transition_count=0;
    mcp4725_i2c #(.CLK_FREQ(CLK_FREQ)) u_dac(
        .clk(sys_clk), .rst(por), .start(dac_start), .dac_code(dac_set),
        .busy(dac_busy), .done(dac_done), .ack_error(dac_ack_error),
        .scl(mcp_scl), .sda(mcp_sda)
    );
    always @(posedge sys_clk) begin
        dac_start<=0;
        if (por) begin
            dac_ready<=0; dac_error<=0; have_code<=0; vg_code<=256; transition_count<=0;
            safe_gate_zeroed<=0;
        end else if (request_adc_reset) begin
            // Keep the safety state single driven: the ADC reset command also
            // arms a fresh gate command, while the DAC controller owns the
            // completion latch.
            safe_gate_zeroed<=0;
        end else begin
            if (apply) dac_error<=0;
            if (safe_gate_requested && !safe_gate_zeroed && !dac_busy && !dac_start && !dac_done) begin
                dac_set<=12'd0; dac_start<=1;
            end else if (!safe_gate_requested && init_done && !init_error && !dac_busy && !dac_start && !dac_done &&
                !dac_error && (!have_code || vg_code!=desired_code)) begin
                dac_set<=desired_code; dac_start<=1;
            end
            if (dac_done) begin
                if (dac_ack_error) begin dac_error<=1; dac_ready<=0; end
                else begin
                    have_code<=1; dac_ready<=1; vg_code<=dac_set;
                    if (safe_gate_requested && dac_set==12'd0) safe_gate_zeroed<=1;
                    transition_count<=transition_count+1'b1;
                end
            end
        end
    end
    (* mark_debug="true" *) reg [15:0] row_ch0=0,row_ch1=0,row_ch2=0,row_ch3=0;
    (* mark_debug="true" *) reg [15:0] row_ch4=0,row_ch5=0,row_ch6=0,row_ch7=0;
    (* mark_debug="true" *) reg row_valid=0,row_bad=0,row_transition=0;
    (* mark_debug="true" *) reg [31:0] row_sequence=0;
    (* mark_debug="true" *) reg [31:0] timestamp_cycles=0;
    (* mark_debug="true" *) reg [31:0] row_start_cycles=0;
    reg [31:0] cycles=0, sweep_start=0, sweep_transition=0;
    reg [11:0] sweep_code=0;
    reg [15:0] sweep_config=0;
    reg [2:0] expected_channel=0;
    reg aligned=0, sweep_bad=0, sweep_busy=0;
    (* mark_debug="true" *) reg [15:0] ffff_run=0;
    (* mark_debug="true" *) reg fault_latched=0;
    (* mark_debug="true" *) reg [3:0] fault_event_reason=0;
    (* mark_debug="true" *) reg [31:0] fault_event_sequence=0;
    (* mark_debug="true" *) reg [31:0] fault_event_timestamp=0;
    (* mark_debug="true" *) reg [15:0] fault_event_config=0;
    (* mark_debug="true" *) reg [11:0] row_start_code=0;
    // Online point statistics for the current stable DAC code.  The host can
    // display these running features without recomputing every raw sample.
    (* mark_debug="true" *) reg [11:0] feature_code=0;
    (* mark_debug="true" *) reg [15:0] feature_samples=0;
    (* mark_debug="true" *) reg [15:0] feature_event_samples=0;
    (* mark_debug="true" *) reg [31:0] feature_sum_ch7=0;
    (* mark_debug="true" *) reg [63:0] feature_sumsq_ch7=0;
    (* mark_debug="true" *) reg [15:0] feature_mean_ch7=0;
    (* mark_debug="true" *) reg [31:0] feature_var_ch7=0;
    (* mark_debug="true" *) reg feature_valid=0;
    reg feature_have_code=0;
    reg [11:0] feature_active_code=0;
    reg [31:0] row_timeout_cycles=0;
    localparam [31:0] ROW_TIMEOUT_LIMIT = CLK_FREQ/200; // 5 ms at 50 MHz
    // Use a fixed eight-row window so the online mean is a shift, keeping the
    // 50 MHz acquisition path free of wide variable dividers.  The raw sum
    // and sum-of-squares remain available to the host for exact statistics.
    wire [16:0] feature_new_count={1'b0,feature_samples}+17'd1;
    wire [32:0] feature_new_sum={1'b0,feature_sum_ch7}+{17'd0,adc_data};
    wire [31:0] adc_square=adc_data*adc_data;
    wire [63:0] feature_new_sumsq=feature_sumsq_ch7+{32'd0,adc_square};
    wire [31:0] feature_new_mean=feature_new_sum >> 3;
    wire [15:0] feature_window_mean=feature_sum_ch7 >> 3;
    wire [31:0] feature_window_second=feature_sumsq_ch7 >> 3;
    wire [31:0] feature_window_mean_square=feature_window_mean*feature_window_mean;
    wire [31:0] feature_window_variance=(feature_window_second>feature_window_mean_square) ?
        feature_window_second-feature_window_mean_square : 32'd0;
    always @(posedge sys_clk) begin
        cycles<=cycles+1'b1; row_valid<=0;
        if (por) begin
            cycles<=0; aligned<=0; row_sequence<=0; ffff_run<=0; fault_latched<=0;
            fault_event_reason<=0; fault_event_sequence<=0; fault_event_timestamp<=0;
            fault_event_config<=0; row_timeout_cycles<=0;
            feature_code<=0; feature_samples<=0; feature_sum_ch7<=0;
            feature_event_samples<=0;
            feature_sumsq_ch7<=0; feature_mean_ch7<=0; feature_var_ch7<=0;
            feature_valid<=0; feature_have_code<=0; feature_active_code<=0;
            safe_gate_requested<=0;
        end else begin
            feature_valid<=0;
            if (request_adc_reset) begin
                fault_latched<=0; safe_gate_requested<=0;
                fault_event_reason<=0; ffff_run<=0; row_timeout_cycles<=0;
            end
            if (!init_done || request_adc_reset) aligned<=0;
            if (init_done && !init_error && !request_adc_reset && wave) begin
                if (row_valid) row_timeout_cycles<=0;
                else if (row_timeout_cycles<ROW_TIMEOUT_LIMIT) row_timeout_cycles<=row_timeout_cycles+1'b1;
                if (row_timeout_cycles>=ROW_TIMEOUT_LIMIT-1 && !fault_latched) begin
                    fault_latched<=1; safe_gate_requested<=1; fault_event_reason<=4'd3;
                    fault_event_sequence<=row_sequence; fault_event_timestamp<=cycles;
                    fault_event_config<=configuration_id;
                end
            end else row_timeout_cycles<=0;
            if (adc_valid && init_done && !request_adc_reset) begin
                if (adc_data==16'hffff) begin
                    if (ffff_run!=65535) ffff_run<=ffff_run+1'b1;
                    if (ffff_run>=15 && !fault_latched) begin
                        fault_latched<=1; safe_gate_requested<=1; fault_event_reason<=4'd1;
                        fault_event_sequence<=row_sequence; fault_event_timestamp<=cycles;
                        fault_event_config<=configuration_id;
                    end
                end else ffff_run<=0;
                if (adc_index==0) begin
                    aligned<=1; expected_channel<=1; row_ch0<=adc_data;
                    sweep_start<=cycles; sweep_code<=vg_code; sweep_config<=configuration_id;
                    sweep_transition<=transition_count; sweep_busy<=dac_busy;
                    sweep_bad<=adc_data==16'hffff;
                end else if (aligned && adc_index==expected_channel) begin
                    expected_channel<=expected_channel+1'b1;
                    sweep_bad<=sweep_bad || adc_data==16'hffff;
                    sweep_busy<=sweep_busy || dac_busy;
                    case (adc_index)
                        1: row_ch1<=adc_data; 2: row_ch2<=adc_data; 3: row_ch3<=adc_data;
                        4: row_ch4<=adc_data; 5: row_ch5<=adc_data; 6: row_ch6<=adc_data;
                        7: begin
                            row_ch7<=adc_data; row_valid<=1; row_sequence<=row_sequence+1'b1;
                            timestamp_cycles<=cycles; row_start_cycles<=sweep_start; row_start_code<=sweep_code;
                            row_bad<=sweep_bad || adc_data==16'hffff || init_error || !dac_ready || dac_error;
                            row_transition<=sweep_busy || dac_busy || sweep_transition!=transition_count ||
                                sweep_config!=configuration_id;
                            // Stable rows feed the point statistics engine.  A
                            // code change emits the completed feature snapshot
                            // and starts a new accumulator with this sample.
                            if (!sweep_bad && adc_data!=16'hffff && !dac_busy &&
                                sweep_transition==transition_count && sweep_config==configuration_id) begin
                                if (!feature_have_code || feature_active_code!=sweep_code) begin
                                    if (feature_have_code && feature_samples>=16'd8) begin
                                        feature_code<=feature_active_code;
                                        feature_event_samples<=feature_samples;
                                        feature_mean_ch7<=feature_window_mean;
                                        feature_var_ch7<=feature_window_variance;
                                        feature_valid<=1;
                                    end
                                    feature_have_code<=1; feature_active_code<=sweep_code;
                                    feature_samples<=1; feature_sum_ch7<=adc_data;
                                    feature_sumsq_ch7<=adc_data*adc_data;
                                end else begin
                                    if (feature_samples<16'd8) begin
                                        feature_samples<=feature_new_count[15:0];
                                        feature_sum_ch7<=feature_new_sum[31:0];
                                        feature_sumsq_ch7<=feature_new_sumsq;
                                        feature_mean_ch7<=feature_new_mean[15:0];
                                    end
                                end
                            end
                        end
                    endcase
                end else aligned<=0;
            end
        end
    end
    experiment_vio u_control(
        .clk(sys_clk), .probe_in0(configuration_id),
        .probe_out0(request_low), .probe_out1(request_high), .probe_out2(request_half_cycles),
        .probe_out3(request_wave), .probe_out4(request_adc_reset), .probe_out5(request_apply)
    );
    assign led={1'b1,!fault_latched,!(init_done && !init_error && dac_ready && !dac_error),cycles[24]};
endmodule
