wdzz8/ads8688-mos-test-platform/tests/mos_experiment_tb.sv

`timescale 1ns / 1ps
// mos_scan 顶层仿真：ADS8688 SPI 从机模型 + MCP4725 I2C 从机模型
//
// 覆盖点：
//   1. 初始化命令序列与寄存器回读（init_error 必须为 0）
//   2. DAC 写入码按 CODE_START + point*CODE_STEP 递增
//   3. 每个扫描点只输出一行，且行的 8 个通道值与整扫边界对齐
//   4. SWEEPS 轮多点平均正确（模型让同一通道在相邻两轮相差 4，
//      平均结果应恰好是 base+2，单点采样得不到该值）
//   5. 一轮扫完 point 回绕、scan_count 递增
module mos_experiment_tb;
    localparam integer POINTS = 4;
    localparam integer STEP   = 128;
    localparam integer SWEEPS  = 2;

    reg clk = 0;
    always #10 clk = ~clk;

    wire adc_cs_n, adc_sclk, adc_sdi, adc_rst_n;
    wire adc_sdo;
    wire mcp_scl, mcp_sda;
    wire [3:0] led;

    mos_experiment dut (
        .sys_clk(clk), .adc_cs_n(adc_cs_n), .adc_sclk(adc_sclk), .adc_sdi(adc_sdi),
        .adc_sdo(adc_sdo), .adc_rst_n(adc_rst_n),
        .mcp_sda(mcp_sda), .mcp_scl(mcp_scl), .led(led)
    );

    //======================================================================
    // ADS8688 SPI 从机模型
    //======================================================================
    reg  [15:0] sdo_value = 0;
    assign adc_sdo = adc_cs_n ? 1'bz : sdo_value;
    pullup(adc_sdo);

    integer   frame   = -1;
    integer   falling = 0;
    integer   rising  = 0;
    reg [15:0] command = 0;
    reg [15:0] frame_data;
    reg [7:0]  echo_data;
    time last_sdi_change = 0;

    // 与 mos_scan 里实例化的 RANGE0..7 一致
    function automatic [15:0] expected_command(input integer number);
        case (number)
            0:  expected_command = 16'h8500;  // SOFT_RESET
            1:  expected_command = 16'h03FF;  // AUTO_SEQ_EN
            2:  expected_command = 16'h0500;  // CH_PD
            3:  expected_command = 16'h0B00;  // CHIR_0 = ±10.24V
            4:  expected_command = 16'h0D06;  // CHIR_1 = 0..5.12V
            5:  expected_command = 16'h0F00;  // CHIR_2
            6:  expected_command = 16'h1106;  // CHIR_3
            7:  expected_command = 16'h1300;
            8:  expected_command = 16'h1500;
            9:  expected_command = 16'h1700;
            10: expected_command = 16'h1906;  // CHIR_7
            11: expected_command = 16'hA000;  // AUTO_RST
            default: expected_command = 16'h0000;
        endcase
    endfunction

    function automatic [15:0] channel_base(input integer channel);
        channel_base = 16'h1000 + channel * 16'h0100;
    endfunction

    // 相邻两轮整扫给同一通道相差 4，用于验证 SWEEPS 轮平均
    function automatic [15:0] conversion_data(input integer frame_number);
        integer channel, sweep_parity;
        begin
            channel      = (frame_number - 12) % 8;
            sweep_parity = ((frame_number - 12) / 8) % 2;
            conversion_data = channel_base(channel) + (sweep_parity ? 16'd4 : 16'd0);
        end
    endfunction

    always @(adc_sdi) last_sdi_change = $time;

    always @(negedge adc_cs_n) begin
        if (!adc_rst_n) $fatal(1, "SPI started while RST asserted");
        frame   = frame + 1;
        falling = 0;
        rising  = 0;
        command = 0;
        sdo_value = 0;
        // Delay the injected fault long enough to observe one low/high DAC
        // transition before the PL safety fallback is exercised.  The ADC
        // model's frame cadence is faster than the nominal 416 us row period,
        // so start after roughly 470 frames rather than 140.
        frame_data = (frame >= 470 && frame < 502) ? 16'hffff : ((frame >= 12) ? conversion_data(frame) : 16'h0000);
    end

    always @(posedge adc_sclk) begin
        if (adc_cs_n) $fatal(1, "SCLK rising while CS high");
        rising = rising + 1;
    end

    always @(negedge adc_sclk) begin
        if (frame >= 0) begin
            if (adc_cs_n) $fatal(1, "CS released before final SCLK falling edge");
            if ($time - last_sdi_change < 5) $fatal(1, "SDI setup time violated");
            falling = falling + 1;
            if (falling <= 16) command = {command[14:0], adc_sdi};
            if (falling == 16) begin
                if (command !== expected_command(frame))
                    $fatal(1, "Frame %0d command %04h, expected %04h",
                           frame, command, expected_command(frame));
                echo_data = command[7:0];
            end
            if (frame >= 1 && frame <= 10) begin
                if (falling >= 16 && falling <= 23) sdo_value <= #30 echo_data[23 - falling];
                else                                 sdo_value <= #30 1'b0;
            end else begin
                if (falling >= 16 && falling <= 31) sdo_value <= #30 frame_data[31 - falling];
                else                                 sdo_value <= #30 1'b0;
            end
        end
    end

    always @(posedge adc_cs_n) begin
        if (frame >= 0) begin
            if (rising != falling) $fatal(1, "Incomplete SCLK cycle in frame %0d", frame);
            if (falling != ((frame >= 1 && frame <= 10) ? 24 : 32))
                $fatal(1, "Wrong frame length: frame %0d, clocks %0d", frame, falling);
        end
    end

    //======================================================================
    // MCP4725 I2C 从机模型：紧跟 START、8 位数据、ACK，记录写入码
    //======================================================================
    reg  slave_low = 0;
    assign mcp_sda = slave_low ? 1'b0 : 1'bz;
    pullup(mcp_sda);
    pullup(mcp_scl);

    integer i2c_writes = 0;
    reg [11:0] written_code [0:63];
    reg [11:0] last_code = 12'hFFF;

    initial forever begin : i2c_slave
        reg [7:0] rx;
        reg [7:0] bytes [0:2];
        integer b, bit_number;
        @(negedge mcp_sda);
        if (mcp_scl === 1'b1 && dut.u_dac.busy) begin
            for (b = 0; b < 3; b = b + 1) begin
                for (bit_number = 7; bit_number >= 0; bit_number = bit_number - 1) begin
                    @(posedge mcp_scl);
                    rx[bit_number] = mcp_sda;
                end
                bytes[b] = rx;
                @(negedge mcp_scl);
                #1 slave_low = 1'b1;
                @(posedge mcp_scl);
                @(negedge mcp_scl);
                #1 slave_low = 1'b0;
            end
            @(posedge mcp_sda);
            if (mcp_scl !== 1'b1) $fatal(1, "I2C STOP without SCL high");
            if (bytes[0] !== 8'hC0) $fatal(1, "I2C address byte %02h", bytes[0]);
            last_code = {bytes[1][3:0], bytes[2]};
            if (i2c_writes < 64) written_code[i2c_writes] = last_code;
            i2c_writes = i2c_writes + 1;
        end
    end

    //======================================================================
    integer rows=0, bad_rows=0, transitions=0, feature_events=0;
    reg [31:0] previous_timestamp=0;
    always @(negedge clk) if (dut.row_valid) begin
        rows=rows+1;
        if (dut.row_sequence!=rows) $fatal(1, "Sequence mismatch");
        if (rows>1 && dut.timestamp_cycles-previous_timestamp!=20800) $fatal(1,"Not a 416 us unaveraged sweep");
        previous_timestamp=dut.timestamp_cycles;
        if (dut.timestamp_cycles-dut.row_start_cycles!=18200) $fatal(1,"Wrong channel skew");
        if (!dut.row_bad) begin
            if (dut.row_ch1-dut.row_ch0!=256 || dut.row_ch7-dut.row_ch0!=1792)
                $fatal(1,"Channel ordering or averaging error");
            if (dut.row_ch0!=16'h1000 && dut.row_ch0!=16'h1004) $fatal(1,"Raw sample was averaged");
        end else bad_rows=bad_rows+1;
        if (dut.row_transition) transitions=transitions+1;
    end
    always @(negedge clk) if (dut.feature_valid) begin
        feature_events=feature_events+1;
        if (dut.feature_event_samples!=8) $fatal(1,"Online feature window is not eight rows");
        if (dut.feature_mean_ch7==0) $fatal(1,"Online feature mean missing");
        if (dut.feature_var_ch7==0) $fatal(1,"Online feature variance missing");
    end
    initial begin
        #130000000;
        if (rows<100 || bad_rows<4 || !dut.fault_latched) $fatal(1,"Missing sample/fault evidence");
        if (feature_events<1 || !dut.safe_gate_requested || !dut.safe_gate_zeroed || dut.fault_event_reason!=4'd1)
            $fatal(1,"Missing online feature/safety evidence");
        if (i2c_writes<2 || transitions<2) $fatal(1,"Wave did not toggle");
        if (written_code[0]!=256 || written_code[1]!=2816 || written_code[2]!=0) begin
            $display("DEBUG DAC codes=%0d,%0d,%0d writes=%0d safe_zeroed=%b fault=%b reason=%0d event_ts=%0d frame=%0d phase=%b wave=%b row_timeout=%0d feature_events=%0d", written_code[0], written_code[1], written_code[2], i2c_writes, dut.safe_gate_zeroed, dut.fault_latched, dut.fault_event_reason, dut.fault_event_timestamp, frame, dut.phase, dut.wave, dut.row_timeout_cycles, feature_events);
            $fatal(1,"Wrong DAC low/high/safety-zero order");
        end
        if (dut.init_error || dut.dac_error) $fatal(1,"Unexpected communication error");
        $display("PASS: mos_experiment unaveraged sweeps, online features, event latch, PL gate fallback, transition tags, FFFF rejection");
        $finish;
    end
endmodule
module experiment_vio(
    input clk, input [15:0] probe_in0,
    output reg [11:0] probe_out0=256, probe_out1=2816,
    output reg [31:0] probe_out2=250000,
    output reg probe_out3=0, probe_out4=0, probe_out5=0
);
    initial begin
        #80000000; probe_out3=1; probe_out5=1;
        #1000; probe_out5=0;
    end
endmodule
