wdzz8/ads8688-mos-test-platform/(commit log)

2026-11-02 完成 MOS 实测交付与离线演示
    [fixed_vgs_output_points.csv, rows.csv, 通道映射记录.csv]
2026-11-02 补充公开仓库链接
2026-11-02 补充初赛创新点与视频策略
2026-11-02 增加质量门控演示页
2026-11-02 加入轻量智能规划与器件画像演示
2026-11-03 增加FPGA工程指标与时序证据页
2026-11-03 Publish final MOS platform source and submission entry points
    [信号引脚表.csv, 通道映射记录.csv]
